zhzhen0626/FingerViP/Teleop/data/user_data/image/example_user.jpg

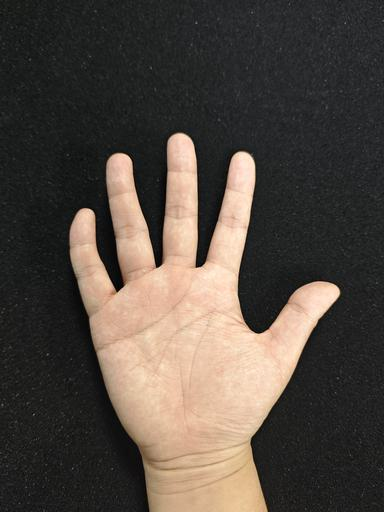
Teleop/data/user_data/image/example_user.jpg
