zhzhen0626/FingerViP/DiffusionPolicy/dexterous_hand/assets/arm/collision/upperarm.obj

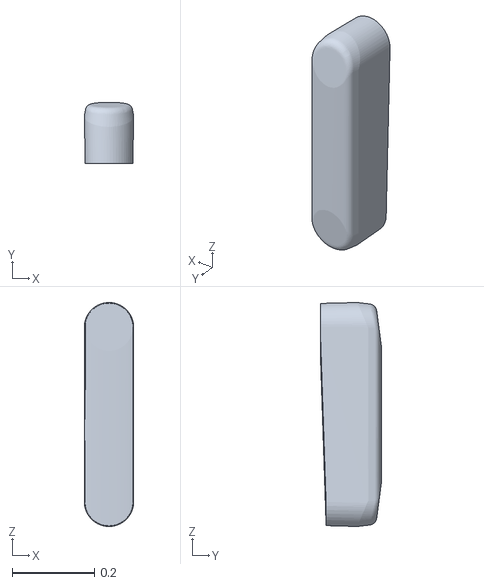
[picture p7: CAD file, 2026-09-24]
DiffusionPolicy/dexterous_hand/assets/arm/collision/upperarm.obj
0.12 x 0.15 x 0.545
