zhzhen0626/FingerViP/DiffusionPolicy/dexterous_hand/assets/arm/visual/forearm.obj

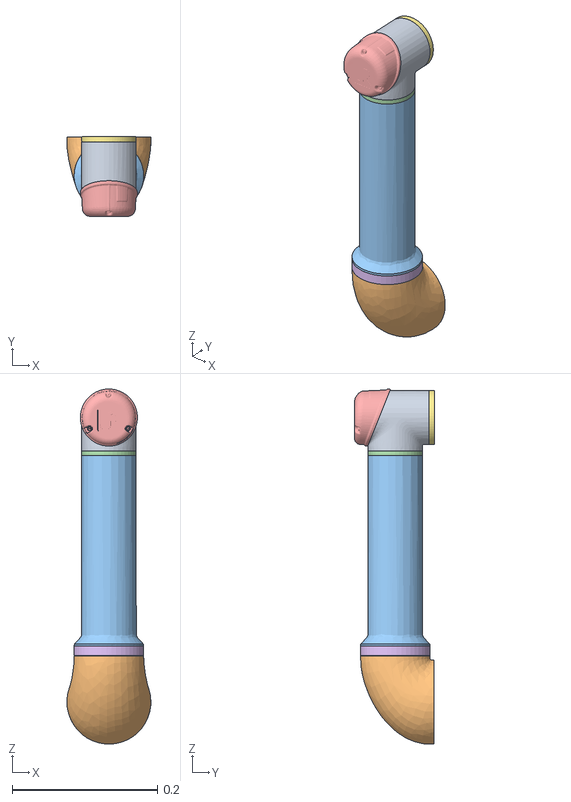
[picture p8: CAD file, 2026-09-24]
DiffusionPolicy/dexterous_hand/assets/arm/visual/forearm.obj
0.116 x 0.11 x 0.489
eSeries_UR5e_028
eSeries_UR5e_020
eSeries_UR5e_022
eSeries_UR5e_023
eSeries_UR5e_024
eSeries_UR5e_021
eSeries_UR5e_025
