zhzhen0626/FingerViP/DiffusionPolicy/dexterous_hand/assets/hand/RPIP.STL

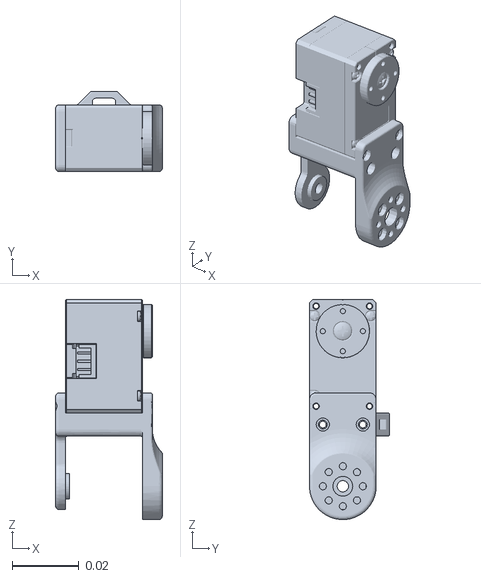
[picture p9: CAD file, 2026-09-24]
DiffusionPolicy/dexterous_hand/assets/hand/RPIP.STL
0.032 x 0.024 x 0.066
