zhzhen0626/FingerViP/Hardware/mechanical_structure/3D Printed Parts/Finger/F2.STL

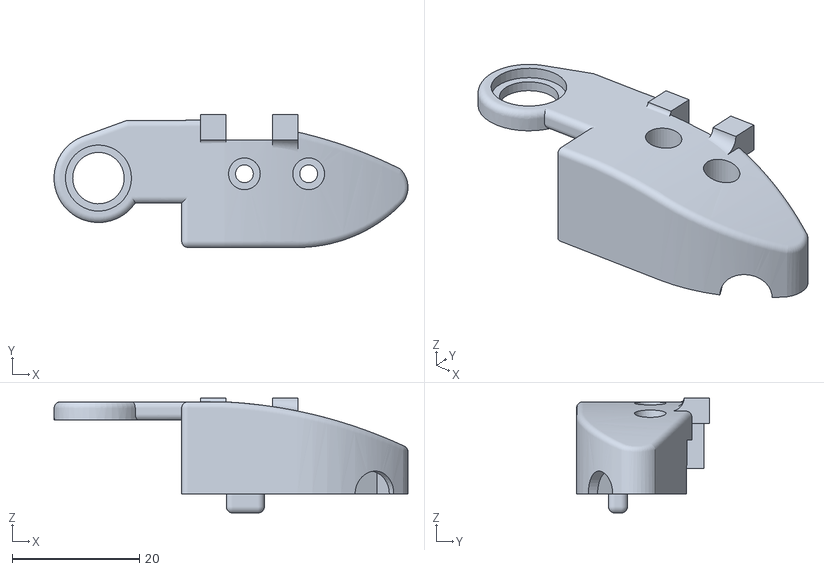
[picture p10: CAD file, 2026-09-24]
Hardware/mechanical_structure/3D Printed Parts/Finger/F2.STL
55.7 x 20.9 x 18.1
