zhzhen0626/FingerViP/Hardware/mechanical_structure/3D Printed Parts/Thumb/T2.STL

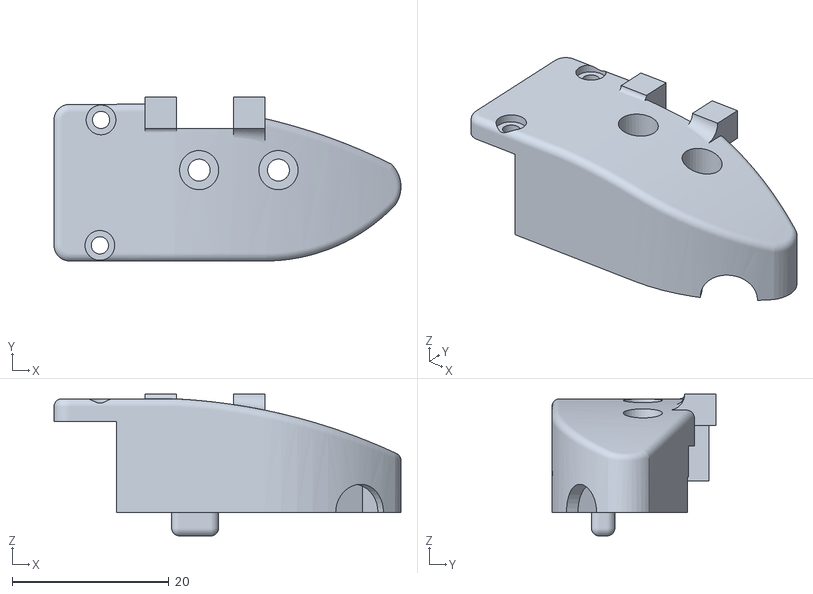
[picture p11: CAD file, 2026-09-24]
Hardware/mechanical_structure/3D Printed Parts/Thumb/T2.STL
44.3 x 20.9 x 18.1
