zhzhen0626/FingerViP/Hardware/mechanical_structure/Model/Finger/Finger.STEP

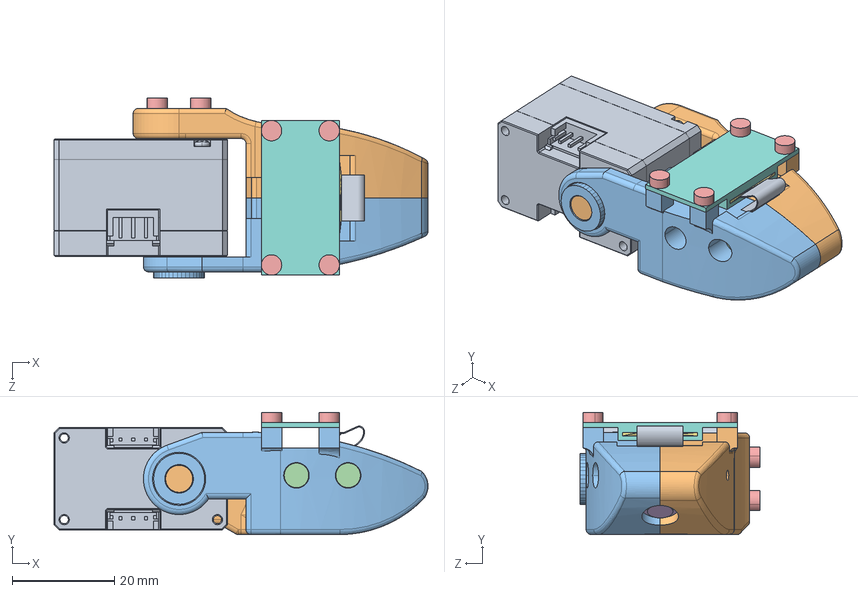
[picture p12: CAD file, 2026-09-24]
Hardware/mechanical_structure/Model/Finger/Finger.STEP
73.2 x 23.9 x 35.1 mm
f1-CamtipR
f2-CamTipL
m2.5_12 x 2
m2_4 x 8
camera.step
XL,XC-330
m3_6
p1-Idler_pin
