zhzhen0626/FingerViP/Teleop/assets/robots/arms/ur10e/meshes/collision/forearm.obj

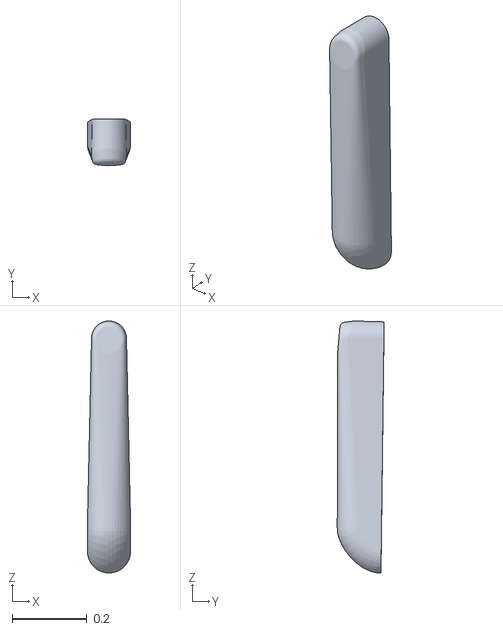
[picture p14: CAD file, 2026-09-24]
Teleop/assets/robots/arms/ur10e/meshes/collision/forearm.obj
0.116 x 0.125 x 0.676
