zhzhen0626/FingerViP/Teleop/assets/robots/arms/ur10e/meshes/visual/base.obj

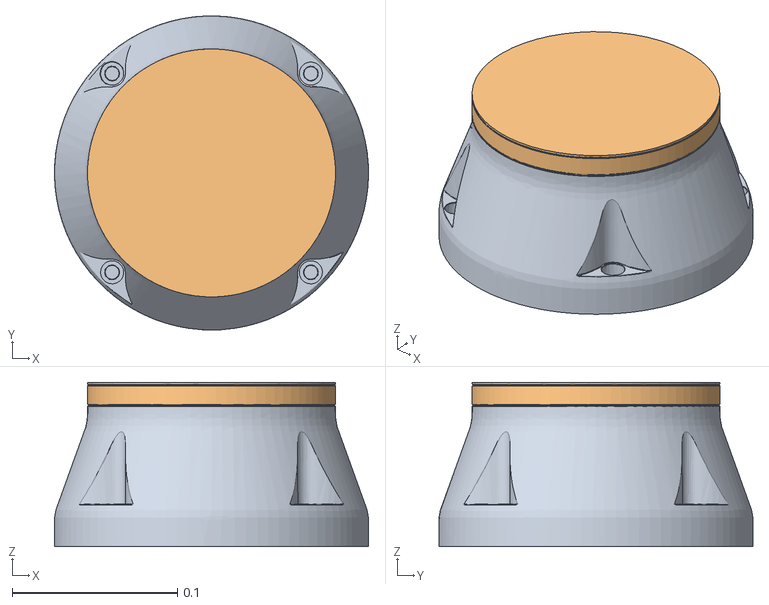
[picture p15: CAD file, 2026-09-24]
Teleop/assets/robots/arms/ur10e/meshes/visual/base.obj
0.19 x 0.19 x 0.0993
eSeries_UR10e_010
eSeries_UR10e_001
