zhzhen0626/FingerViP/Teleop/assets/robots/arms/ur5e/meshes/collision/base.obj

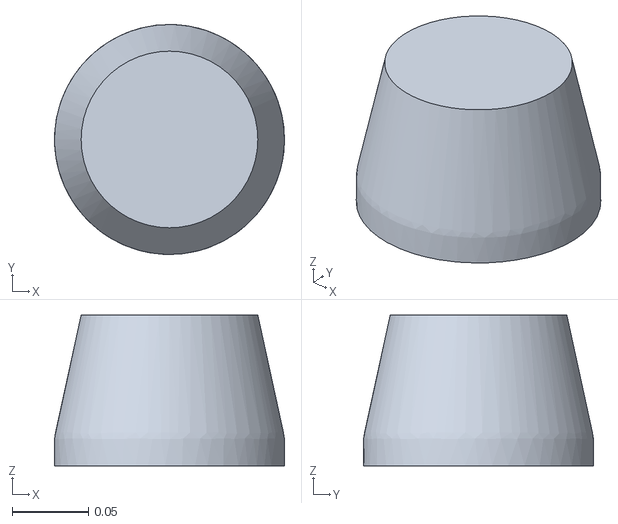
[picture p16: CAD file, 2026-09-24]
Teleop/assets/robots/arms/ur5e/meshes/collision/base.obj
0.151 x 0.151 x 0.0991
