zhzhen0626/FingerViP/Teleop/assets/robots/arms/ur5e/meshes/visual/wrist1.obj

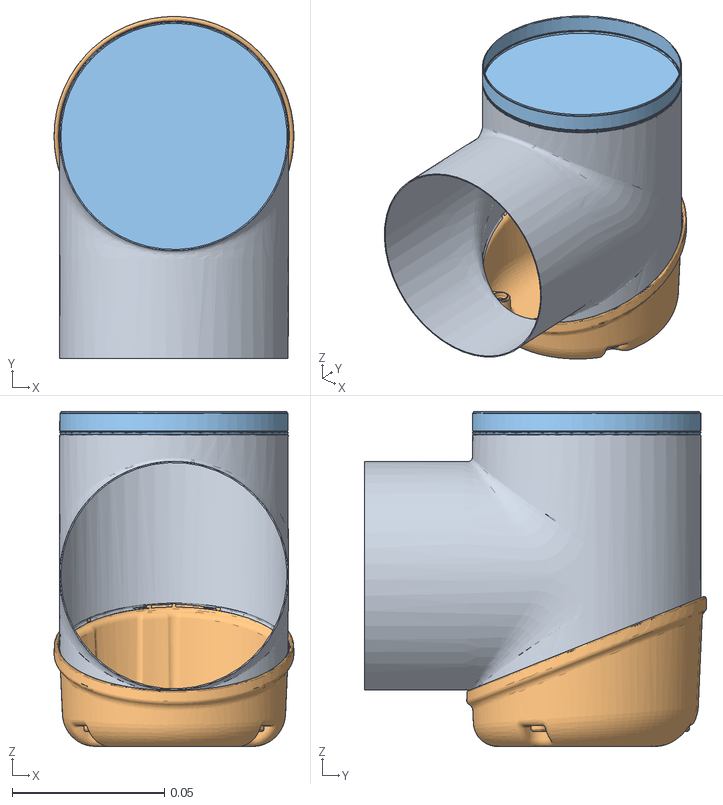
[picture p17: CAD file, 2026-09-24]
Teleop/assets/robots/arms/ur5e/meshes/visual/wrist1.obj
0.0787 x 0.112 x 0.11
eSeries_UR5e_043
eSeries_UR5e_026
eSeries_UR5e_027
