zhzhen0626/FingerViP/Teleop/assets/robots/hands/allegro_hand/meshes/collision/link_tip.obj

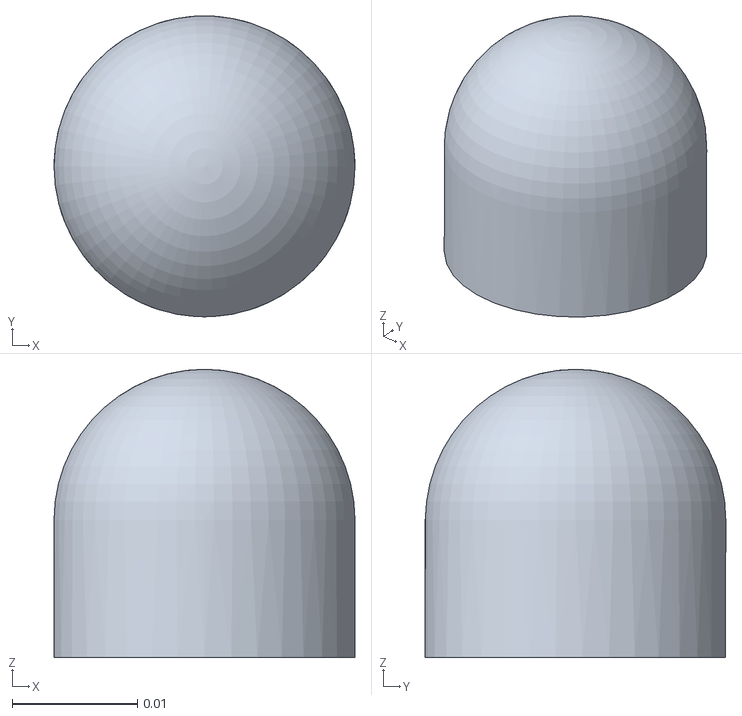
[picture p18: CAD file, 2026-09-24]
Teleop/assets/robots/hands/allegro_hand/meshes/collision/link_tip.obj
0.024 x 0.024 x 0.023
