zhzhen0626/FingerViP/Teleop/assets/robots/hands/allegro_hand/variation/meshes/collision/longer_finger_tip.obj

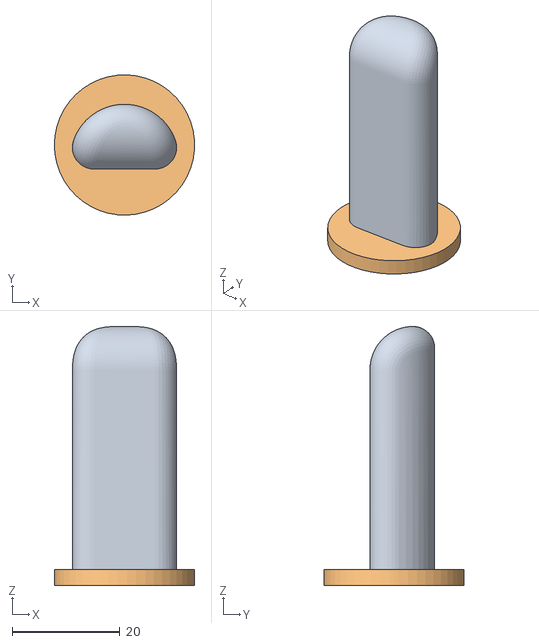
[picture p19: CAD file, 2026-09-24]
Teleop/assets/robots/hands/allegro_hand/variation/meshes/collision/longer_finger_tip.obj
26.0 x 26.0 x 48.0
geometry_0
geometry_1
