zhzhen0626/FingerViP/Teleop/assets/robots/hands/allegro_hand/variation/meshes/visual/tactile.obj

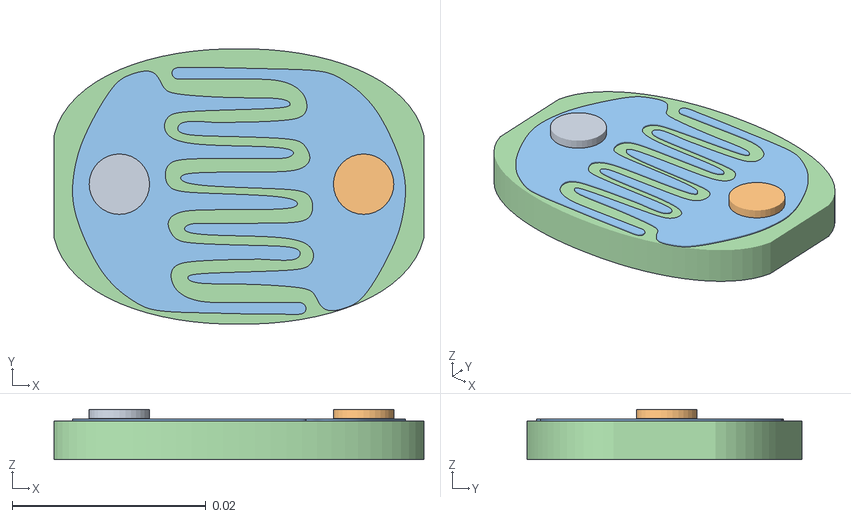
[picture p20: CAD file, 2026-09-24]
Teleop/assets/robots/hands/allegro_hand/variation/meshes/visual/tactile.obj
0.0382 x 0.0284 x 0.00519
LIGHT_CATCHER_2
photocell
