zhzhen0626/FingerViP/Teleop/assets/robots/hands/leap_hand/meshes/collision/white_tip_thumb.obj

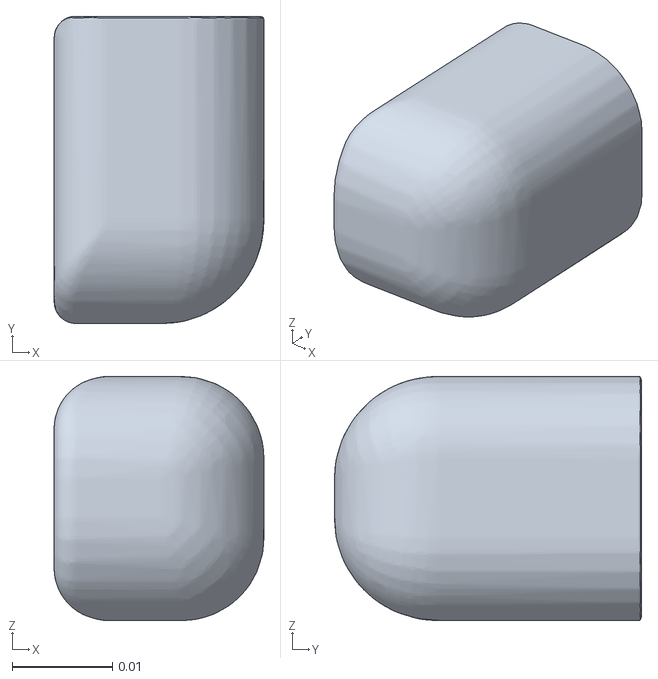
[picture p21: CAD file, 2026-09-24]
Teleop/assets/robots/hands/leap_hand/meshes/collision/white_tip_thumb.obj
0.0209 x 0.0306 x 0.0243
