zhzhen0626/FingerViP/Teleop/assets/robots/hands/leap_hand/meshes/visual/dip.obj

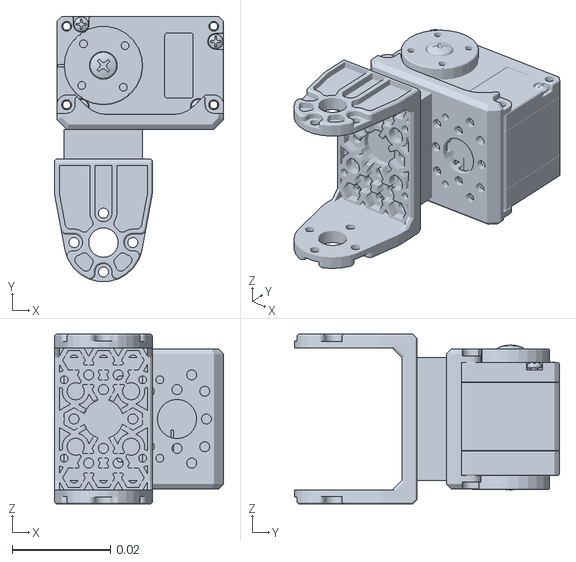
[picture p22: CAD file, 2026-09-24]
Teleop/assets/robots/hands/leap_hand/meshes/visual/dip.obj
0.0345 x 0.054 x 0.0346
