zhzhen0626/FingerViP/Teleop/assets/robots/hands/rapid_hand/meshes/TDIP.STL

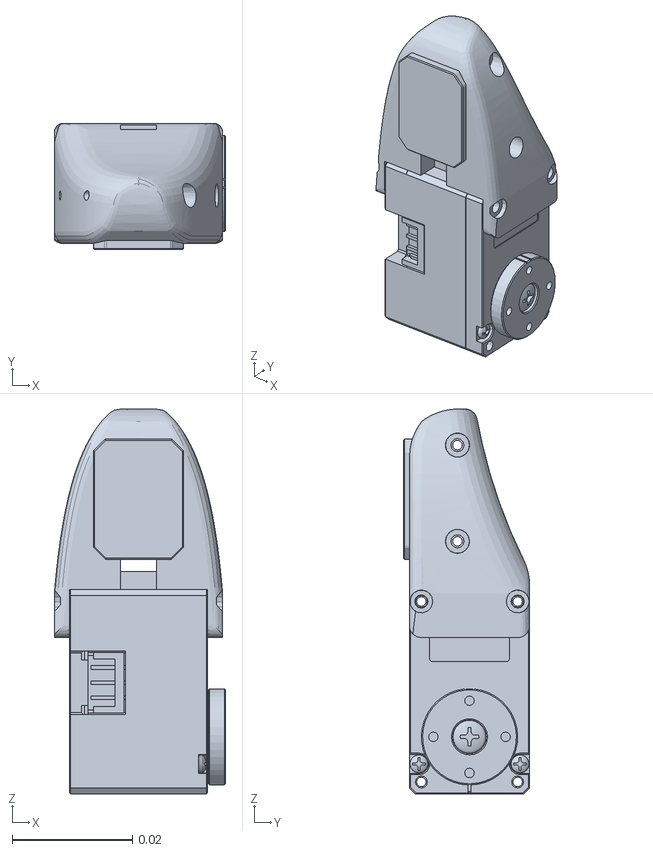
[picture p23: CAD file, 2026-09-24]
Teleop/assets/robots/hands/rapid_hand/meshes/TDIP.STL
0.0285 x 0.021 x 0.064
