zhzhen0626/FingerViP/DiffusionPolicy/dexterous_hand/assets/arm/collision/wrist3.obj

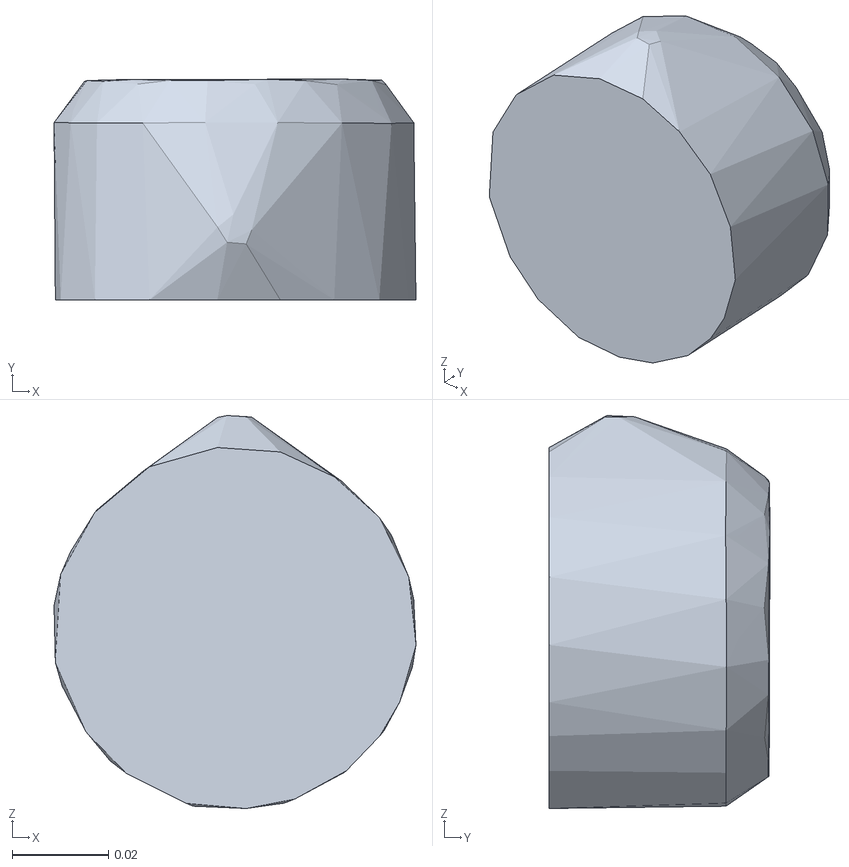
[picture p24: CAD file, 2026-09-24]
DiffusionPolicy/dexterous_hand/assets/arm/collision/wrist3.obj
0.0751 x 0.0458 x 0.0816
