zhzhen0626/FingerViP/DiffusionPolicy/dexterous_hand/assets/arm/visual/upperarm.obj

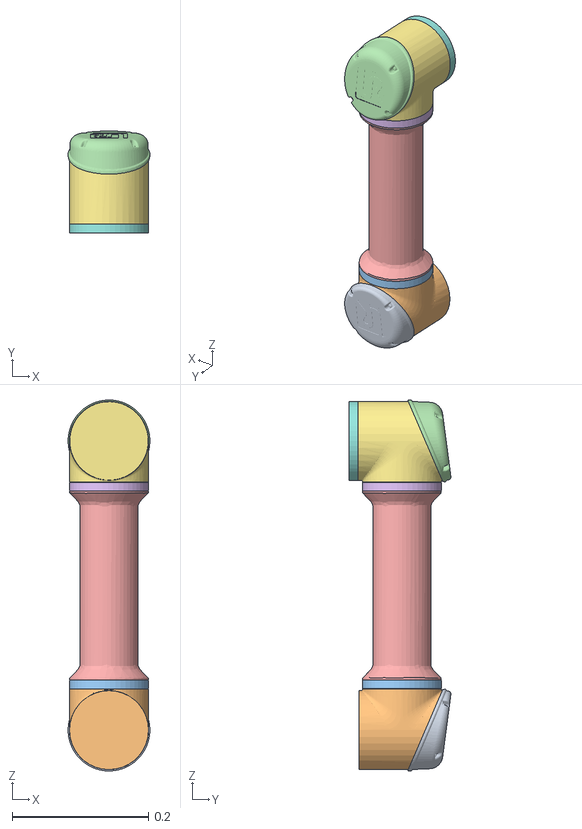
[picture p25: CAD file, 2026-09-24]
DiffusionPolicy/dexterous_hand/assets/arm/visual/upperarm.obj
0.12 x 0.15 x 0.545
eSeries_UR5e_009
eSeries_UR5e_010
eSeries_UR5e_011
eSeries_UR5e_012
eSeries_UR5e_014
eSeries_UR5e_017
eSeries_UR5e_018
eSeries_UR5e_019
