zhzhen0626/FingerViP/DiffusionPolicy/dexterous_hand/assets/hand/IDIP_CT.STL

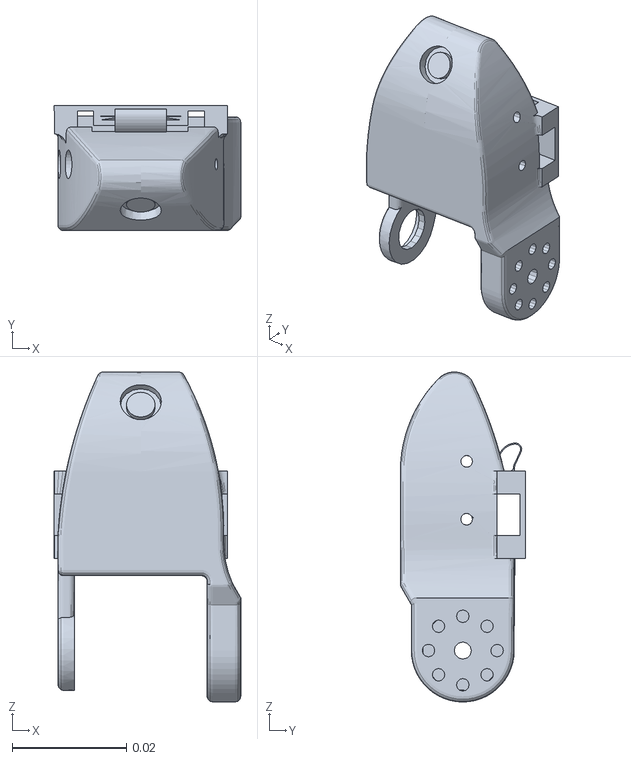
[picture p26: CAD file, 2026-09-24]
DiffusionPolicy/dexterous_hand/assets/hand/IDIP_CT.STL
0.0326 x 0.0219 x 0.0577
