zhzhen0626/FingerViP/Hardware/mechanical_structure/3D Printed Parts/Finger/F1.STL

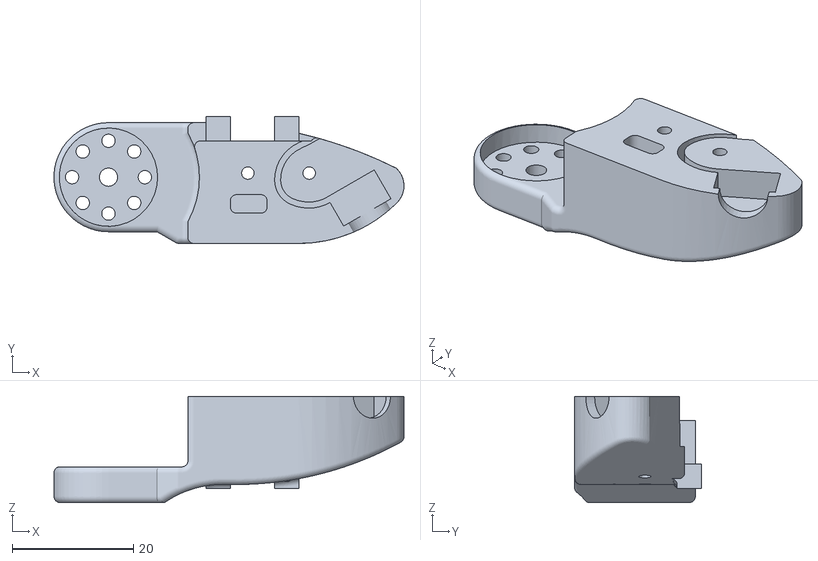
[picture p27: CAD file, 2026-09-24]
Hardware/mechanical_structure/3D Printed Parts/Finger/F1.STL
57.7 x 20.9 x 17.5
