zhzhen0626/FingerViP/Hardware/mechanical_structure/3D Printed Parts/Thumb/T1.STL

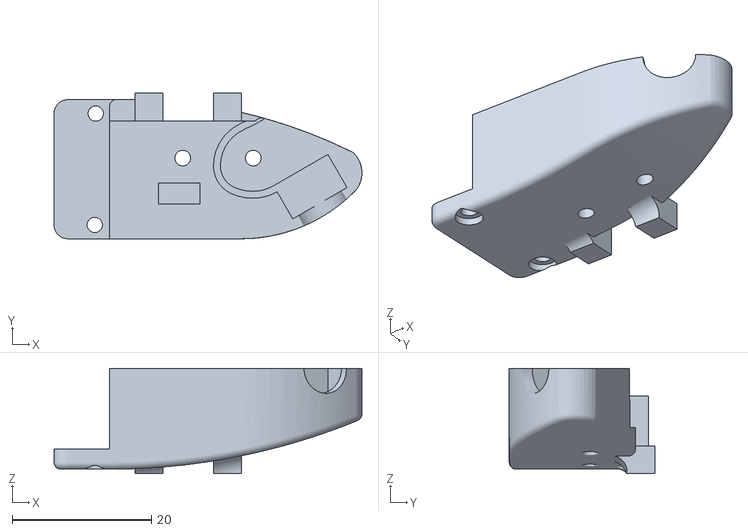
[picture p28: CAD file, 2026-09-24]
Hardware/mechanical_structure/3D Printed Parts/Thumb/T1.STL
44.3 x 20.9 x 15.2
