zhzhen0626/FingerViP/Teleop/assets/robots/arms/ur10e/meshes/collision/shoulder.obj

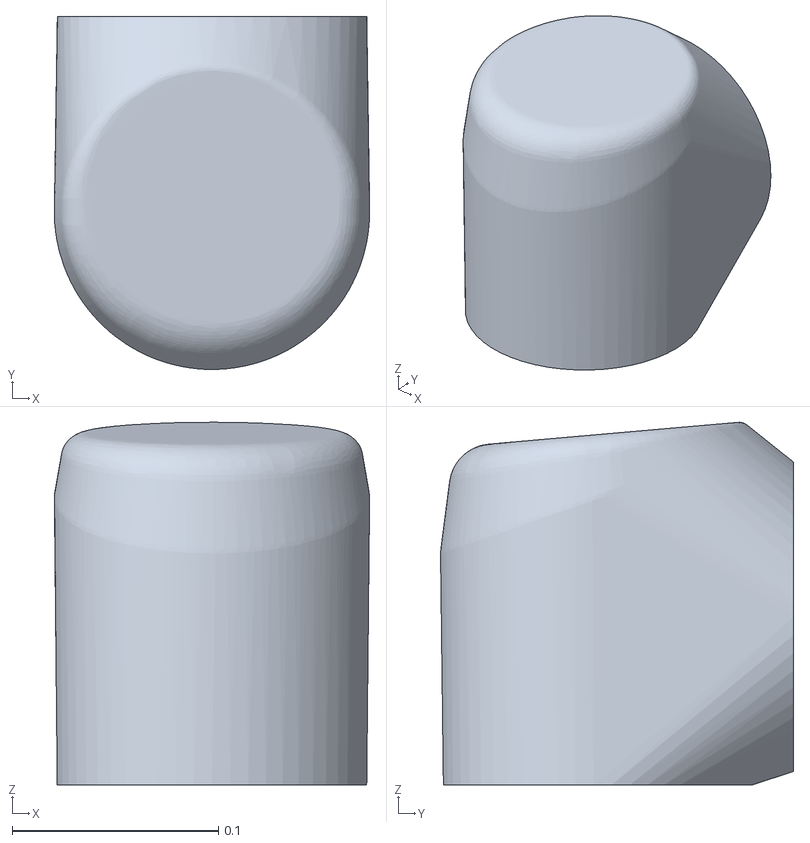
[picture p29: CAD file, 2026-09-24]
Teleop/assets/robots/arms/ur10e/meshes/collision/shoulder.obj
0.153 x 0.171 x 0.176
