zhzhen0626/FingerViP/Teleop/assets/robots/arms/ur10e/meshes/visual/shoulder.obj

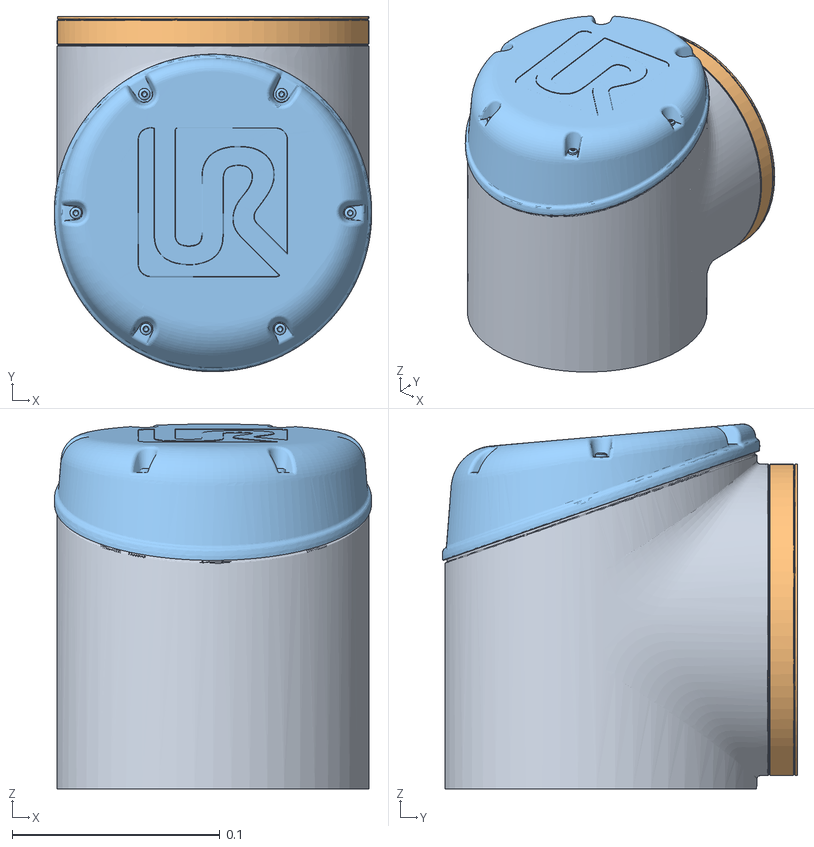
[picture p30: CAD file, 2026-09-24]
Teleop/assets/robots/arms/ur10e/meshes/visual/shoulder.obj
0.153 x 0.171 x 0.176
eSeries_UR10e_023
eSeries_UR10e_002
eSeries_UR10e_003
