zhzhen0626/FingerViP/Teleop/assets/robots/arms/ur5e/meshes/collision/forearm.obj

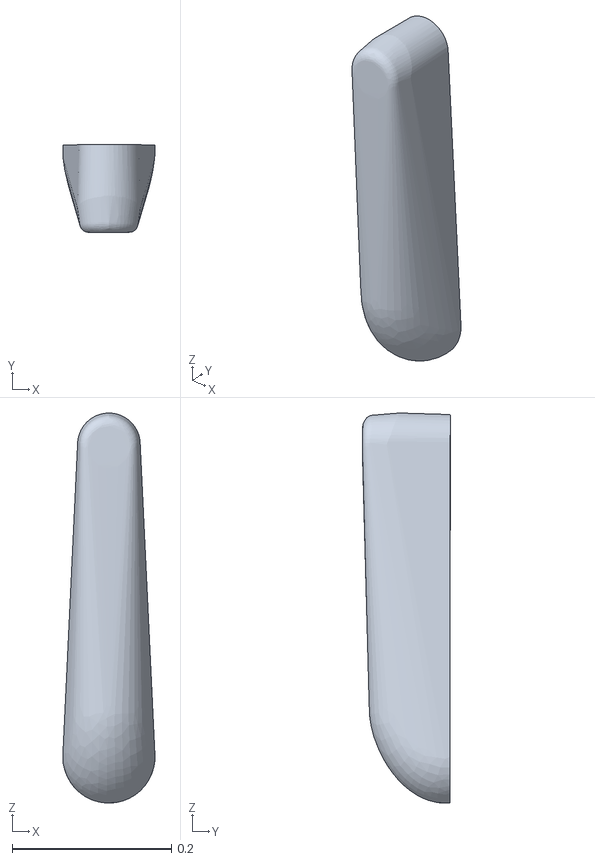
[picture p31: CAD file, 2026-09-24]
Teleop/assets/robots/arms/ur5e/meshes/collision/forearm.obj
0.116 x 0.11 x 0.489
