zhzhen0626/FingerViP/Teleop/assets/robots/arms/ur5e/meshes/visual/shoulder.obj

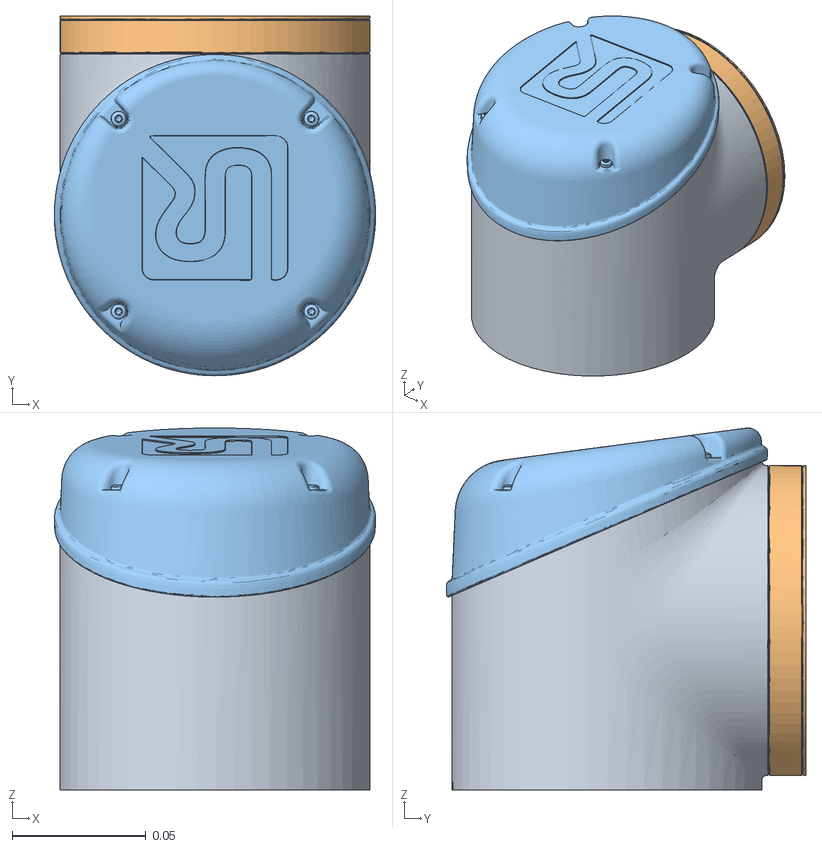
[picture p32: CAD file, 2026-09-24]
Teleop/assets/robots/arms/ur5e/meshes/visual/shoulder.obj
0.12 x 0.135 x 0.135
eSeries_UR5e_001
eSeries_UR5e_007
eSeries_UR5e_008
