zhzhen0626/FingerViP/Teleop/assets/robots/hands/allegro_hand/meshes/visual/base_link.obj

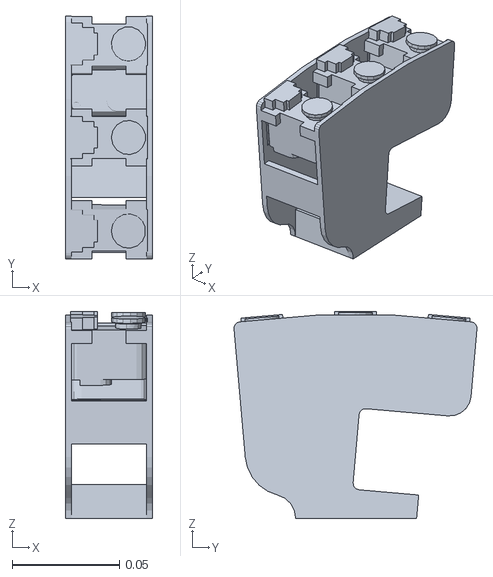
[picture p33: CAD file, 2026-09-24]
Teleop/assets/robots/hands/allegro_hand/meshes/visual/base_link.obj
0.0408 x 0.113 x 0.0967
