zhzhen0626/FingerViP/Teleop/assets/robots/hands/allegro_hand/variation/meshes/visual/longer_finger_tip.obj

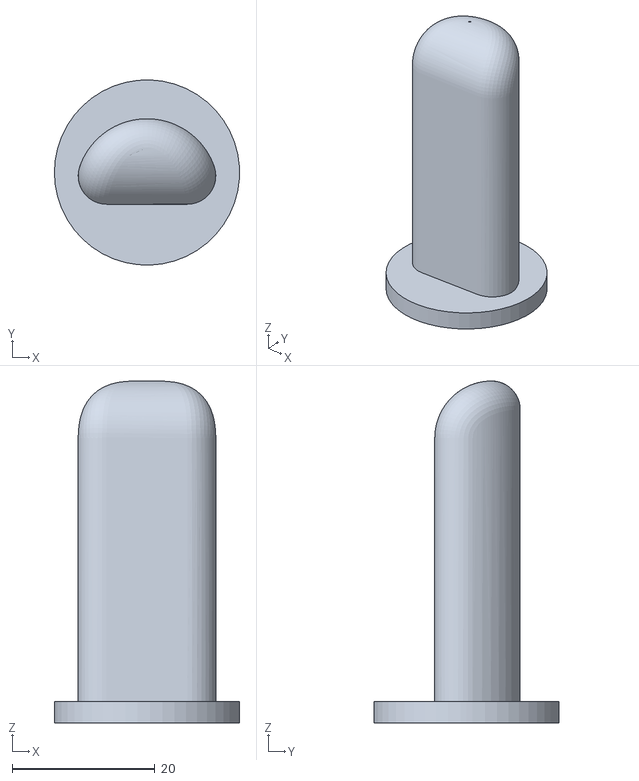
[picture p34: CAD file, 2026-09-24]
Teleop/assets/robots/hands/allegro_hand/variation/meshes/visual/longer_finger_tip.obj
26.0 x 26.0 x 48.0
