zhzhen0626/FingerViP/Teleop/assets/robots/hands/leap_hand/meshes/visual/pip_left.obj

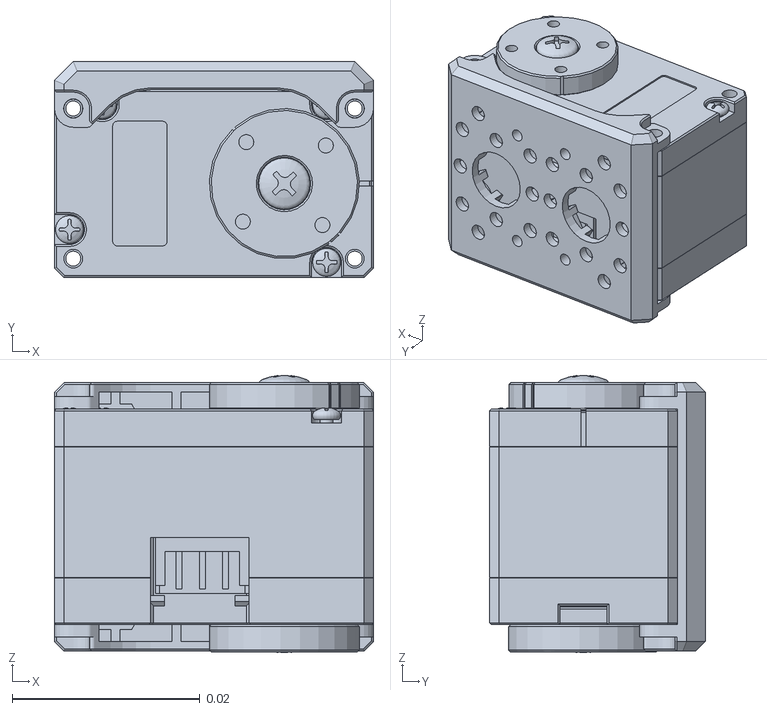
[picture p35: CAD file, 2026-09-24]
Teleop/assets/robots/hands/leap_hand/meshes/visual/pip_left.obj
0.034 x 0.023 x 0.0295
