zhzhen0626/FingerViP/Teleop/assets/robots/hands/rapid_hand/meshes/IDIP.STL

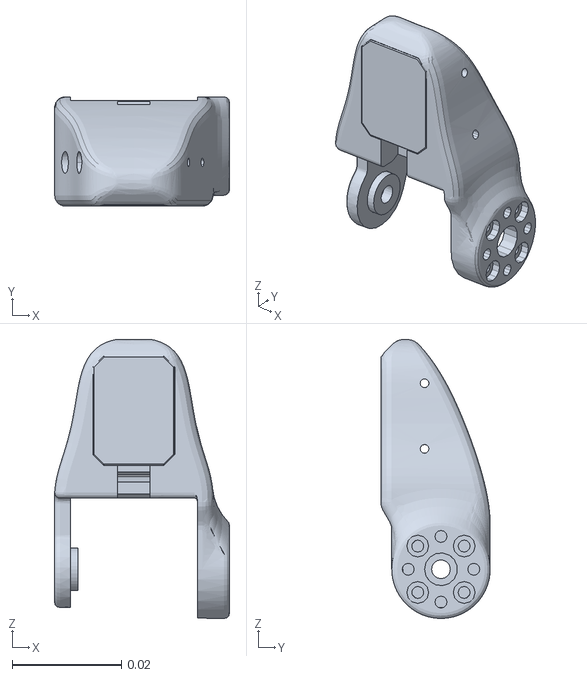
[picture p36: CAD file, 2026-09-24]
Teleop/assets/robots/hands/rapid_hand/meshes/IDIP.STL
0.032 x 0.02 x 0.051
