zhzhen0626/FingerViP/DiffusionPolicy/dexterous_hand/assets/arm/collision/wrist2.obj

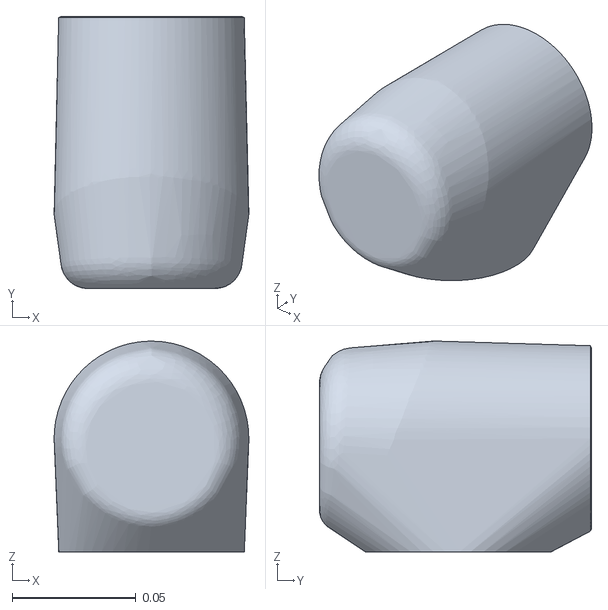
[picture p37: CAD file, 2026-09-24]
DiffusionPolicy/dexterous_hand/assets/arm/collision/wrist2.obj
0.0787 x 0.11 x 0.0852
