zhzhen0626/FingerViP/DiffusionPolicy/dexterous_hand/assets/arm/visual/wrist2.obj

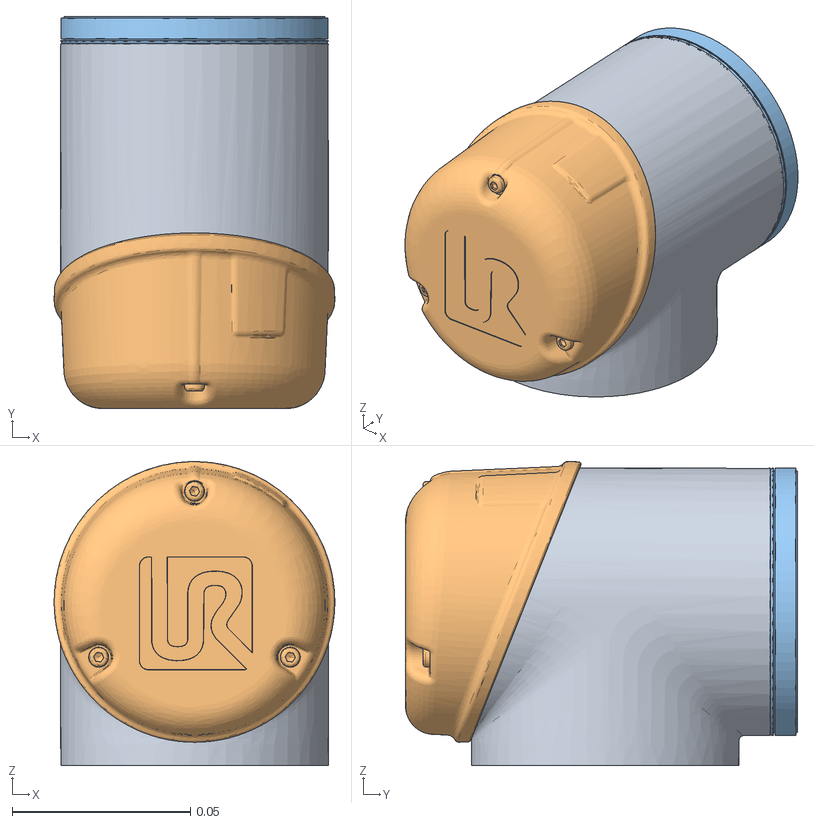
[picture p38: CAD file, 2026-09-24]
DiffusionPolicy/dexterous_hand/assets/arm/visual/wrist2.obj
0.0787 x 0.11 x 0.0852
eSeries_UR5e_049
eSeries_UR5e_029
eSeries_UR5e_002
