zhzhen0626/FingerViP/DiffusionPolicy/dexterous_hand/assets/hand/TMCPF.STL

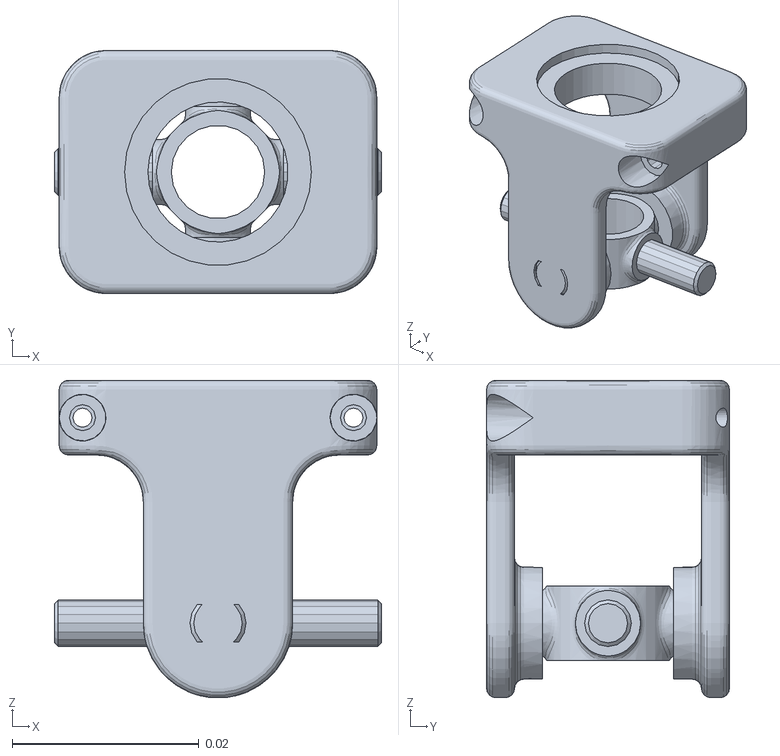
[picture p39: CAD file, 2026-09-24]
DiffusionPolicy/dexterous_hand/assets/hand/TMCPF.STL
0.035 x 0.026 x 0.034
