zhzhen0626/FingerViP/Teleop/assets/robots/arms/ur10e/meshes/collision/wrist3.obj

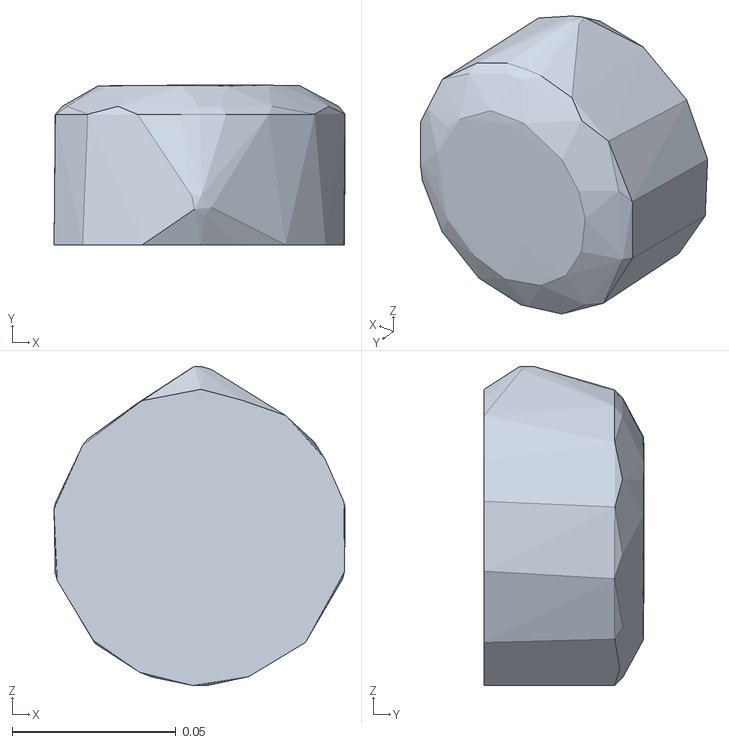
[picture p40: CAD file, 2026-09-24]
Teleop/assets/robots/arms/ur10e/meshes/collision/wrist3.obj
0.0888 x 0.0488 x 0.0974
