zhzhen0626/FingerViP/Teleop/assets/robots/arms/ur10e/meshes/visual/wrist1.obj

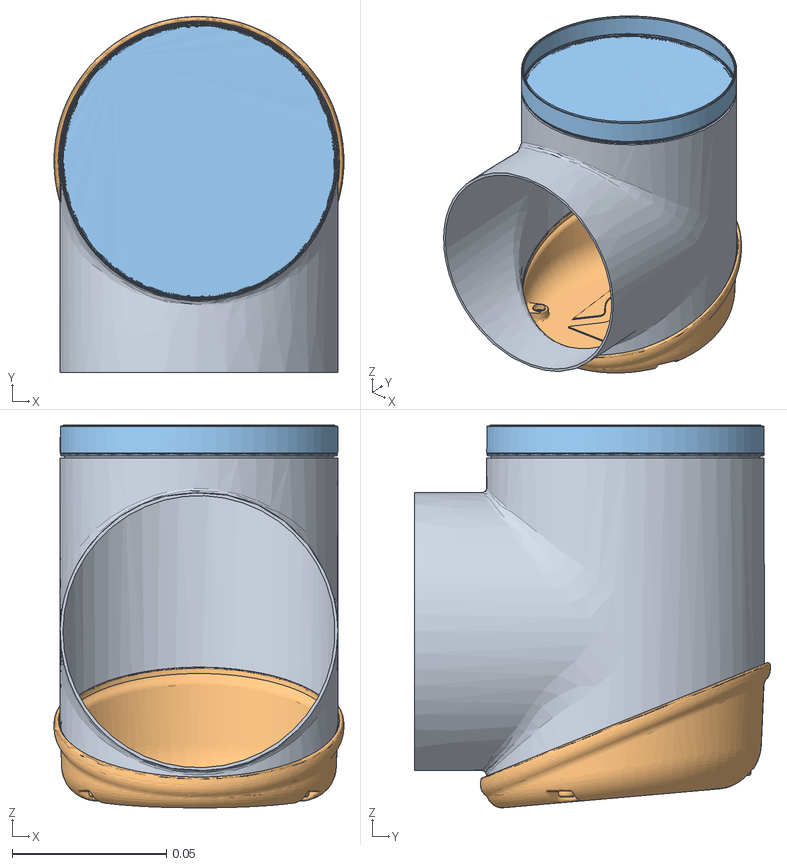
[picture p41: CAD file, 2026-09-24]
Teleop/assets/robots/arms/ur10e/meshes/visual/wrist1.obj
0.094 x 0.115 x 0.124
eSeries_UR10e_037
eSeries_UR10e_021
eSeries_UR10e_022
