zhzhen0626/FingerViP/Teleop/assets/robots/arms/ur5e/meshes/visual/wrist3.obj

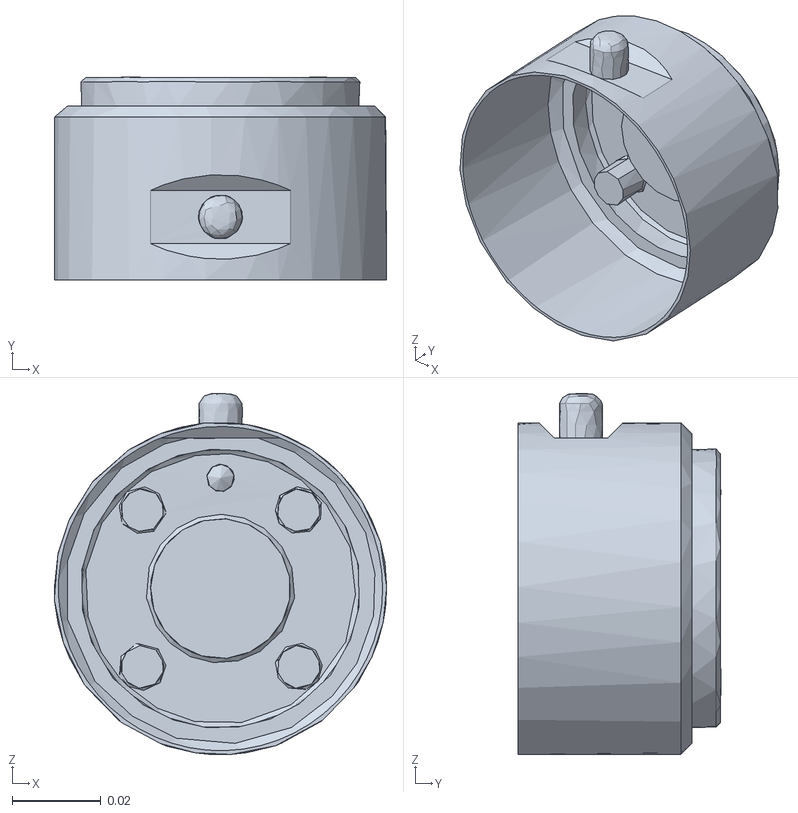
[picture p42: CAD file, 2026-09-24]
Teleop/assets/robots/arms/ur5e/meshes/visual/wrist3.obj
0.0751 x 0.0458 x 0.0816
