zhzhen0626/FingerViP/Teleop/assets/robots/hands/leap_hand/meshes/visual/thumb_pip.obj

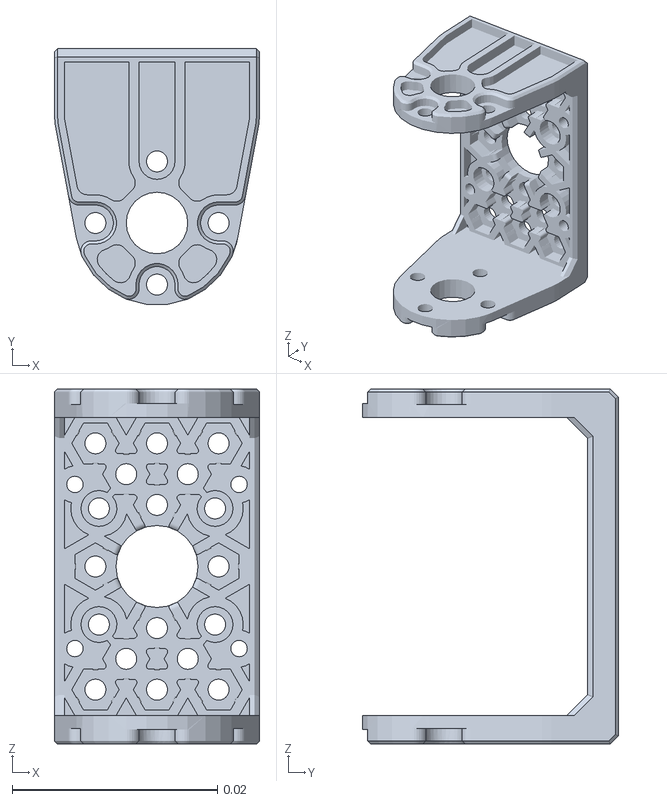
[picture p44: CAD file, 2026-09-24]
Teleop/assets/robots/hands/leap_hand/meshes/visual/thumb_pip.obj
0.02 x 0.0249 x 0.0346
