zhzhen0626/FingerViP/Teleop/assets/robots/hands/rapid_hand/meshes/BASE.STL

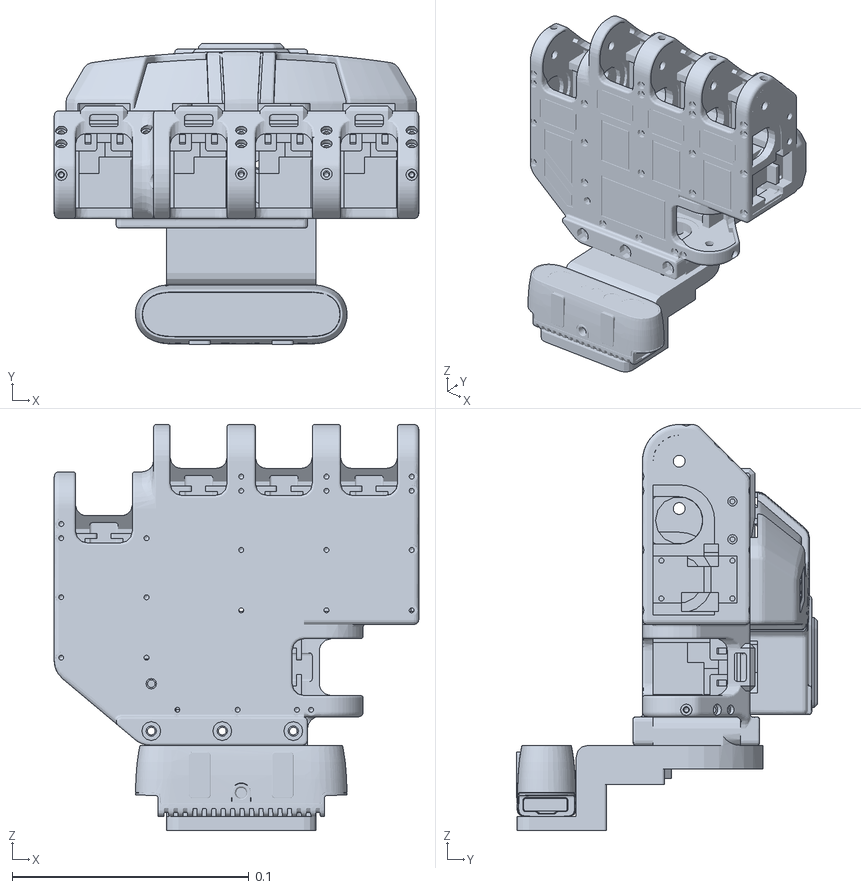
[picture p45: CAD file, 2026-09-24]
Teleop/assets/robots/hands/rapid_hand/meshes/BASE.STL
0.154 x 0.127 x 0.172
