zhzhen0626/FingerViP/DiffusionPolicy/dexterous_hand/assets/arm/collision/shoulder.obj

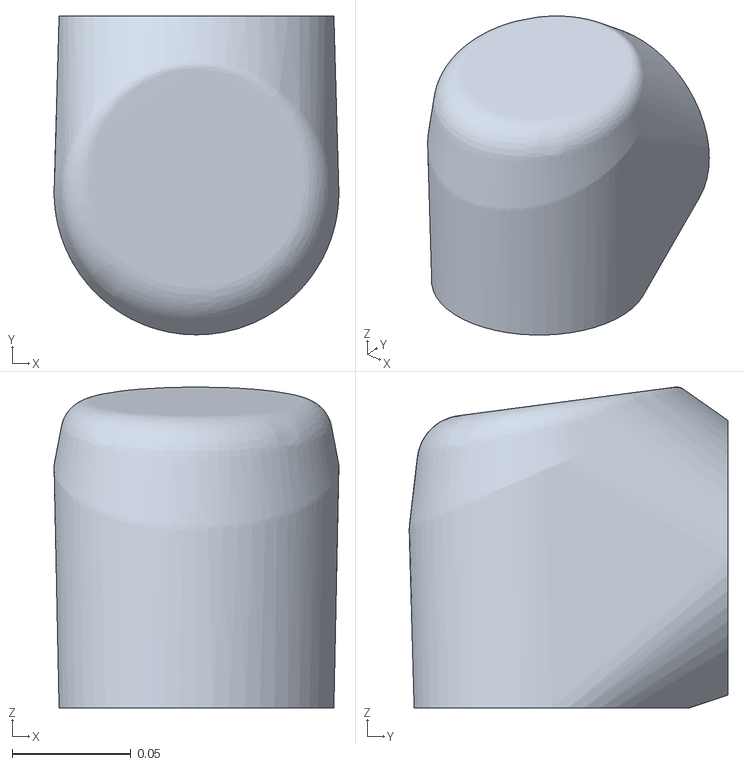
[picture p46: CAD file, 2026-09-24]
DiffusionPolicy/dexterous_hand/assets/arm/collision/shoulder.obj
0.12 x 0.134 x 0.135
