zhzhen0626/FingerViP/Teleop/assets/robots/arms/ur10e/meshes/collision/wrist2.obj

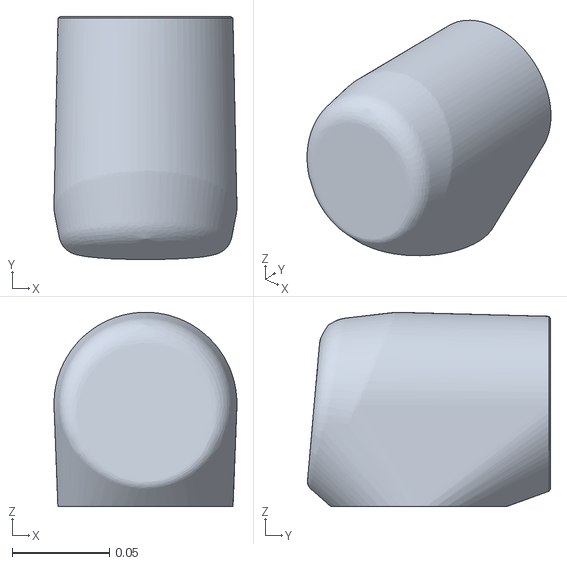
[picture p47: CAD file, 2026-09-24]
Teleop/assets/robots/arms/ur10e/meshes/collision/wrist2.obj
0.094 x 0.125 x 0.0999
