zhzhen0626/FingerViP/Teleop/assets/robots/arms/ur10e/meshes/visual/upperarm.obj

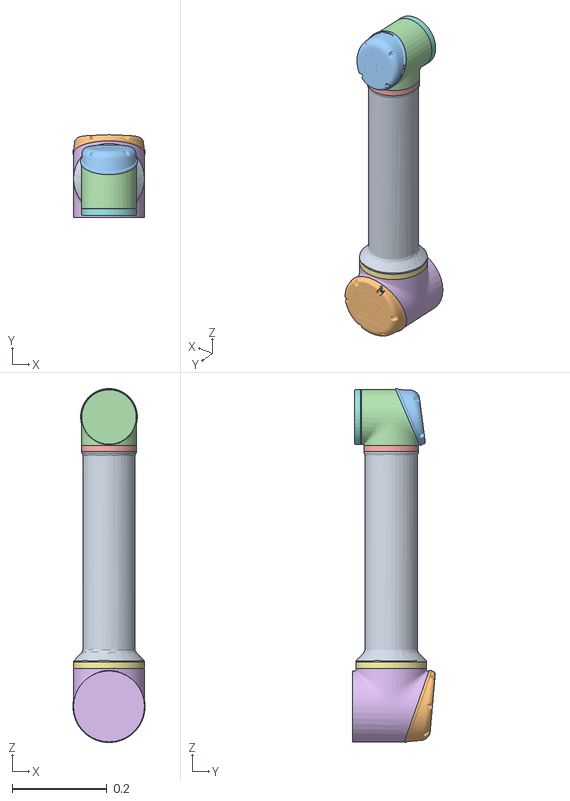
[picture p48: CAD file, 2026-09-24]
Teleop/assets/robots/arms/ur10e/meshes/visual/upperarm.obj
0.153 x 0.175 x 0.749
eSeries_UR10e_028
eSeries_UR10e_004
eSeries_UR10e_005
eSeries_UR10e_007
eSeries_UR10e_008
eSeries_UR10e_009
eSeries_UR10e_011
eSeries_UR10e_014
