zhzhen0626/FingerViP/Teleop/assets/robots/hands/leap_hand/meshes/visual/palm_lower_left.obj

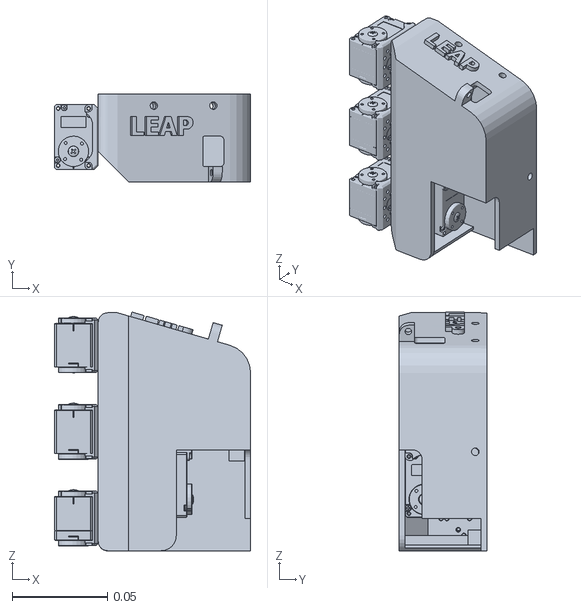
[picture p50: CAD file, 2026-09-24]
Teleop/assets/robots/hands/leap_hand/meshes/visual/palm_lower_left.obj
0.103 x 0.046 x 0.125
