zhzhen0626/FingerViP/Teleop/assets/robots/hands/rapid_hand/meshes/LMCPS.STL

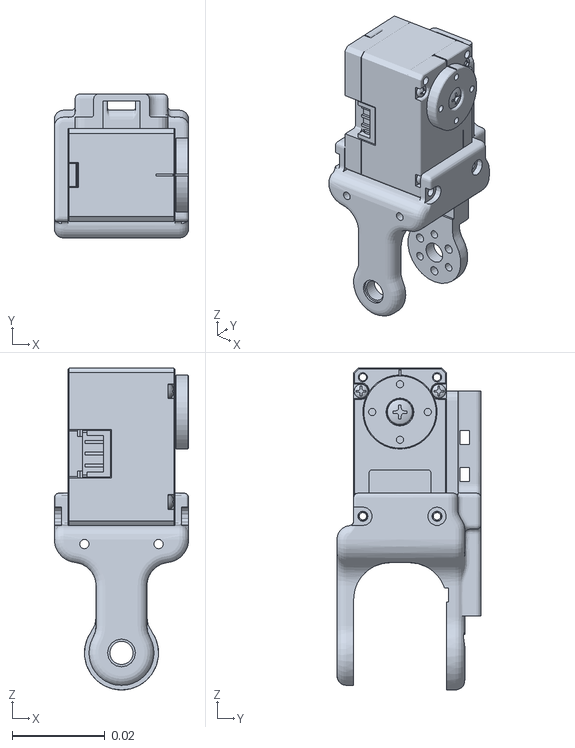
[picture p51: CAD file, 2026-09-24]
Teleop/assets/robots/hands/rapid_hand/meshes/LMCPS.STL
0.029 x 0.0311 x 0.0695
