zhzhen0626/FingerViP/DiffusionPolicy/dexterous_hand/assets/hand/IMCPF.STL

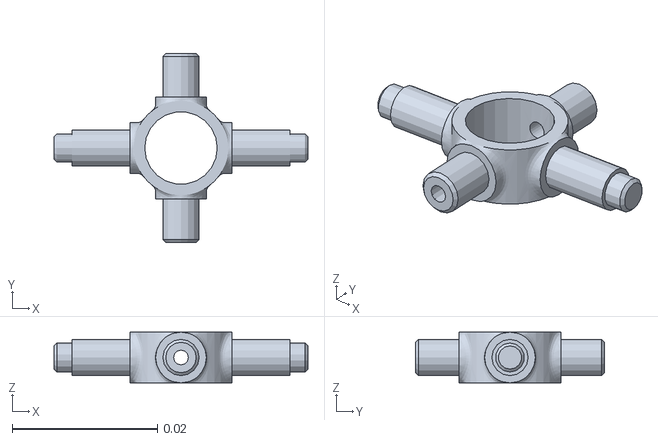
[picture p52: CAD file, 2026-09-24]
DiffusionPolicy/dexterous_hand/assets/hand/IMCPF.STL
0.035 x 0.026 x 0.007
