zhzhen0626/FingerViP/Teleop/assets/robots/arms/ur10e/meshes/visual/wrist3.obj

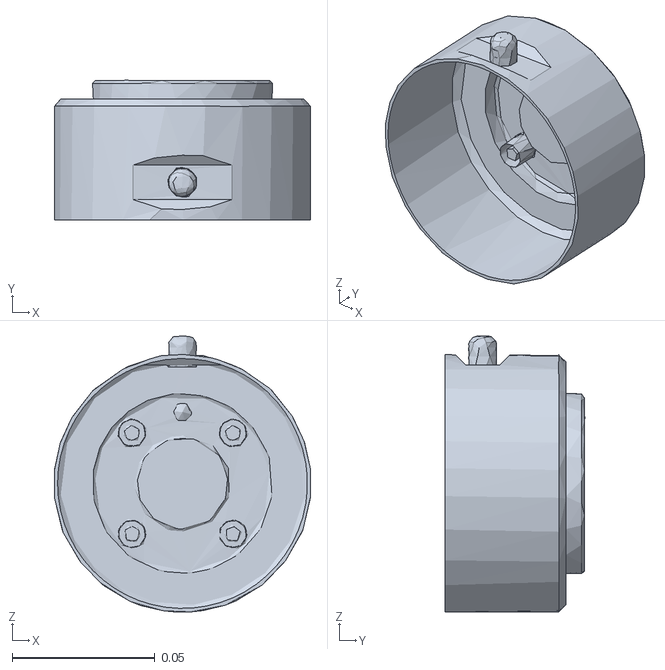
[picture p53: CAD file, 2026-09-24]
Teleop/assets/robots/arms/ur10e/meshes/visual/wrist3.obj
0.0897 x 0.0488 x 0.0966
