zhzhen0626/FingerViP/Teleop/assets/robots/arms/ur5e/meshes/collision/wrist1.obj

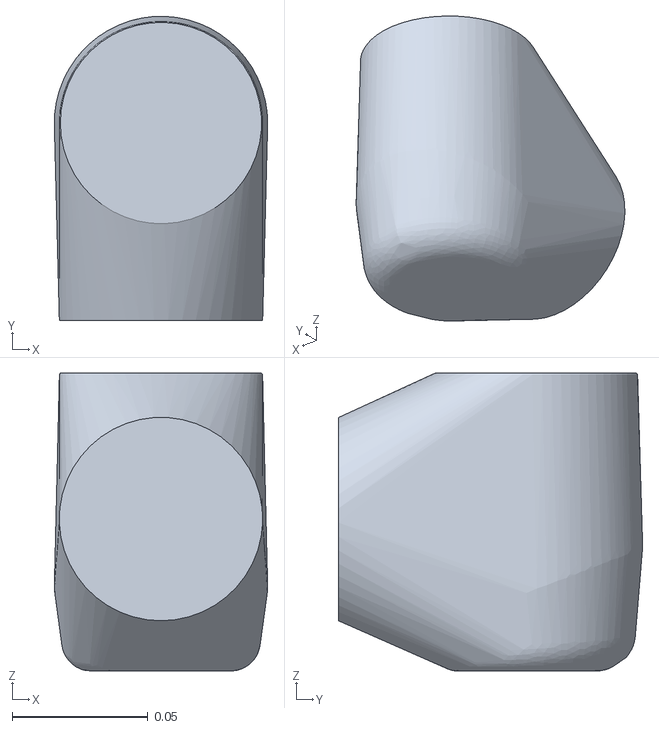
[picture p54: CAD file, 2026-09-24]
Teleop/assets/robots/arms/ur5e/meshes/collision/wrist1.obj
0.0787 x 0.112 x 0.11
