zhzhen0626/FingerViP/Teleop/assets/robots/hands/allegro_hand/meshes/visual/link_2.0.obj

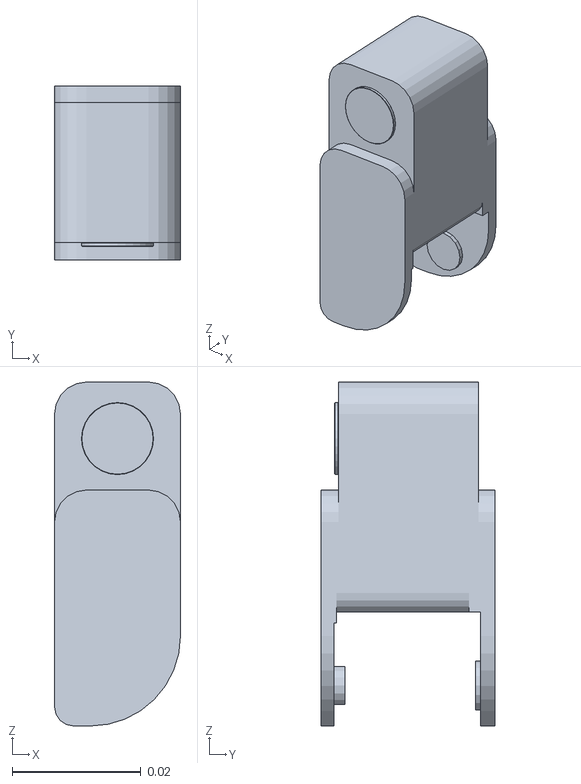
[picture p55: CAD file, 2026-09-24]
Teleop/assets/robots/hands/allegro_hand/meshes/visual/link_2.0.obj
0.0196 x 0.027 x 0.0535
