zhzhen0626/FingerViP/Teleop/assets/robots/hands/leap_hand/meshes/visual/fingertip.obj

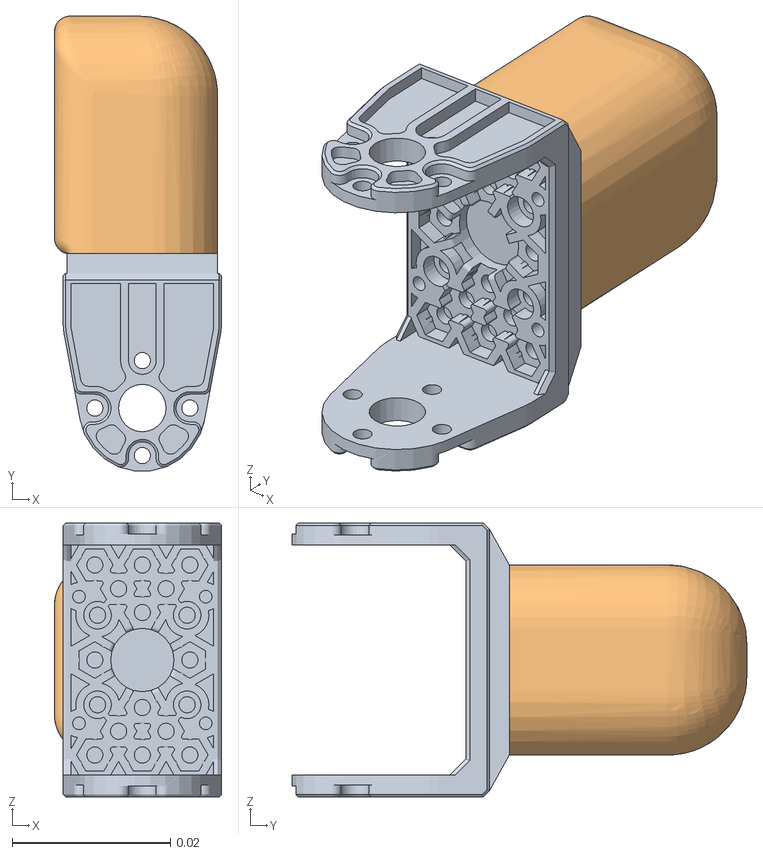
[picture p56: CAD file, 2026-09-24]
Teleop/assets/robots/hands/leap_hand/meshes/visual/fingertip.obj
0.0211 x 0.0574 x 0.0346
fingertip
fingertip_W
