zhzhen0626/FingerViP/Teleop/assets/robots/arms/ur10e/meshes/collision/wrist1.obj

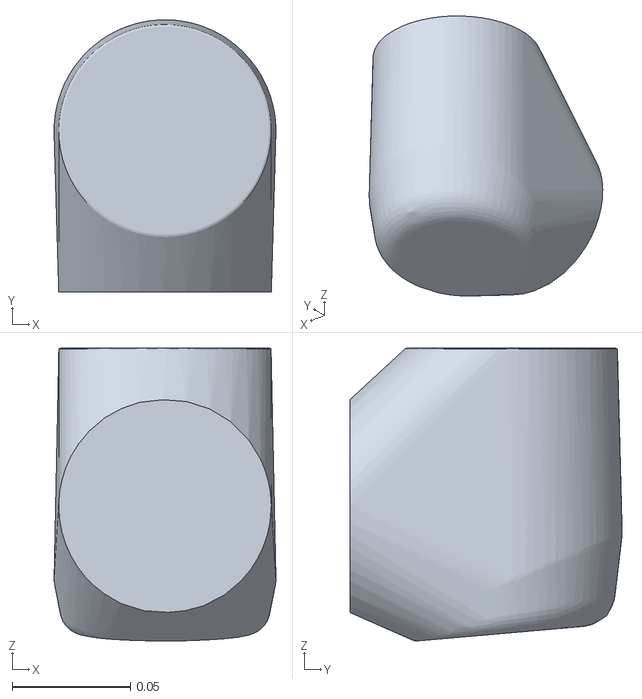
[picture p57: CAD file, 2026-09-24]
Teleop/assets/robots/arms/ur10e/meshes/collision/wrist1.obj
0.094 x 0.115 x 0.124
