zhzhen0626/FingerViP/Teleop/assets/robots/arms/ur10e/meshes/visual/forearm.obj

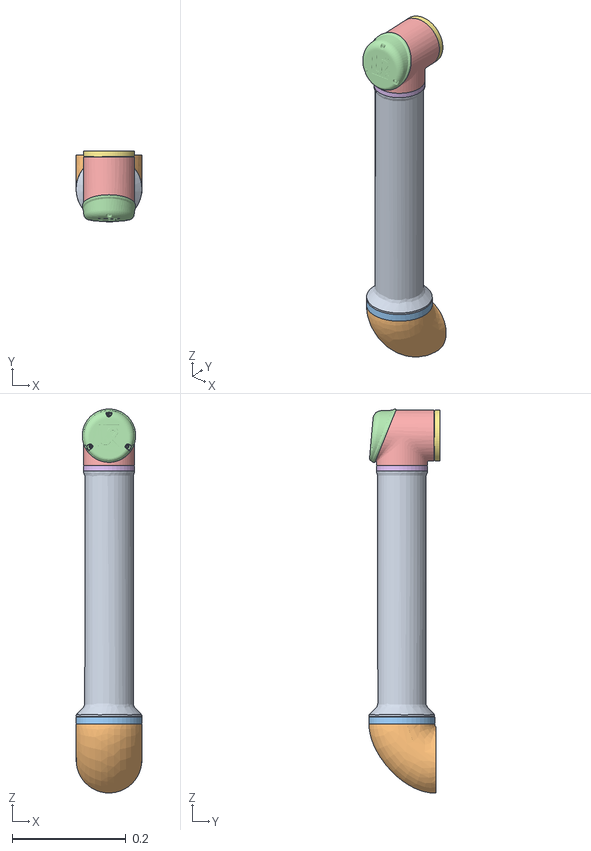
[picture p58: CAD file, 2026-09-24]
Teleop/assets/robots/arms/ur10e/meshes/visual/forearm.obj
0.116 x 0.125 x 0.676
eSeries_UR10e_031
eSeries_UR10e_015
eSeries_UR10e_016
eSeries_UR10e_017
eSeries_UR10e_018
eSeries_UR10e_019
eSeries_UR10e_020
