zhzhen0626/FingerViP/Teleop/assets/robots/arms/ur5e/meshes/visual/base.obj

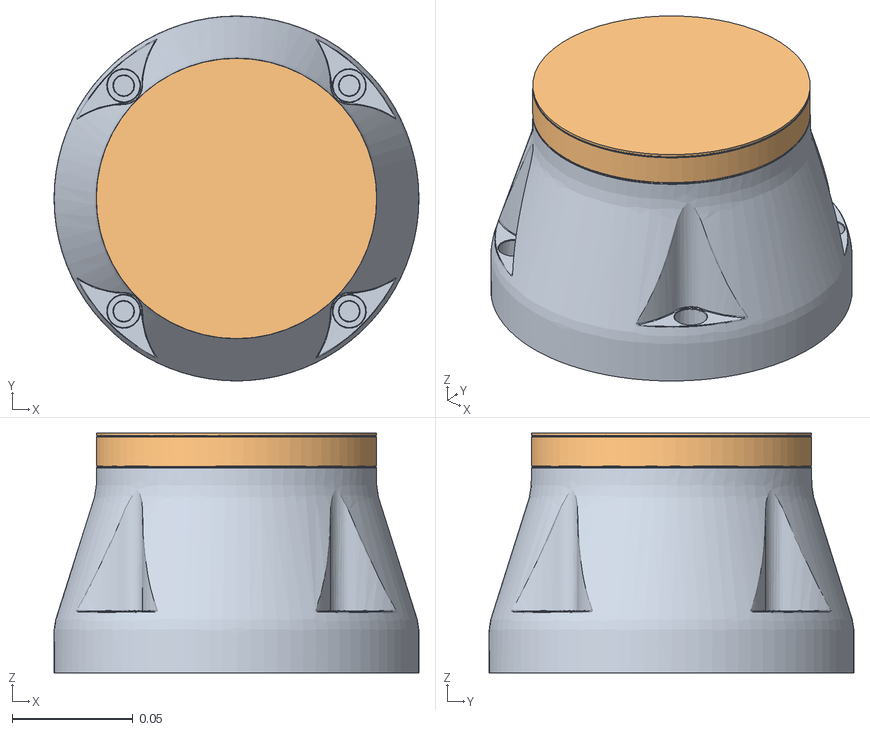
[picture p59: CAD file, 2026-09-24]
Teleop/assets/robots/arms/ur5e/meshes/visual/base.obj
0.151 x 0.151 x 0.0991
eSeries_UR5e_013
eSeries_UR5e_006
