zhzhen0626/FingerViP/Teleop/assets/robots/hands/allegro_hand/meshes/visual/link_12.0_right.obj

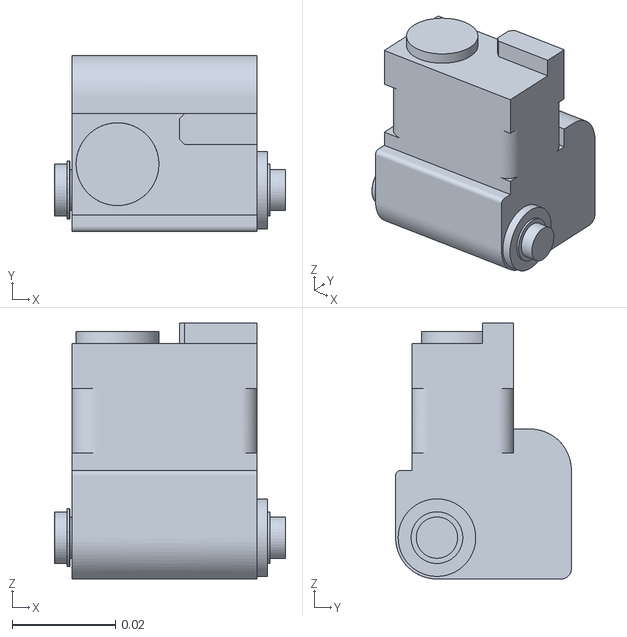
[picture p60: CAD file, 2026-09-24]
Teleop/assets/robots/hands/allegro_hand/meshes/visual/link_12.0_right.obj
0.0447 x 0.034 x 0.0495
