zhzhen0626/FingerViP/Teleop/assets/robots/hands/leap_hand/meshes/visual/palm_lower.obj

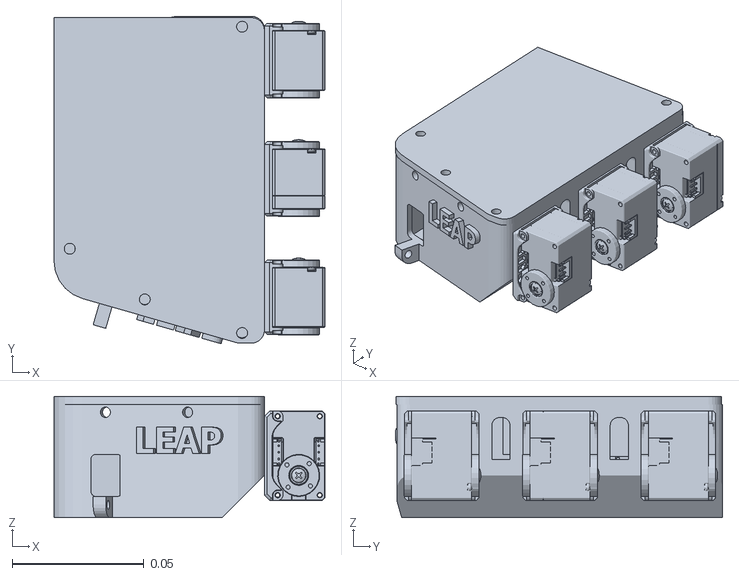
[picture p61: CAD file, 2026-09-24]
Teleop/assets/robots/hands/leap_hand/meshes/visual/palm_lower.obj
0.103 x 0.124 x 0.046
