zhzhen0626/FingerViP/Teleop/assets/robots/arms/ur10e/meshes/collision/upperarm.obj

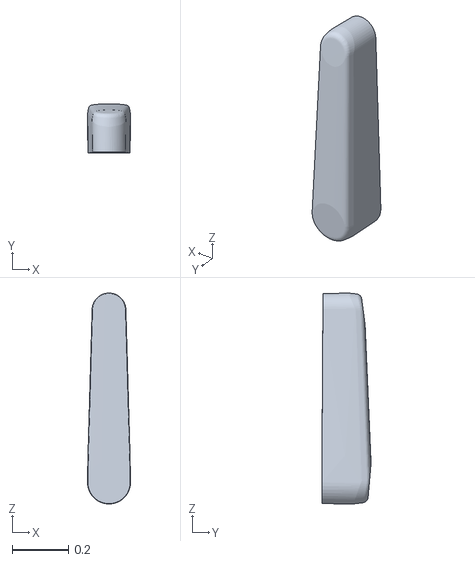
[picture p62: CAD file, 2026-09-24]
Teleop/assets/robots/arms/ur10e/meshes/collision/upperarm.obj
0.153 x 0.175 x 0.749
