zhzhen0626/FingerViP/Teleop/assets/robots/arms/ur10e/meshes/visual/wrist2.obj

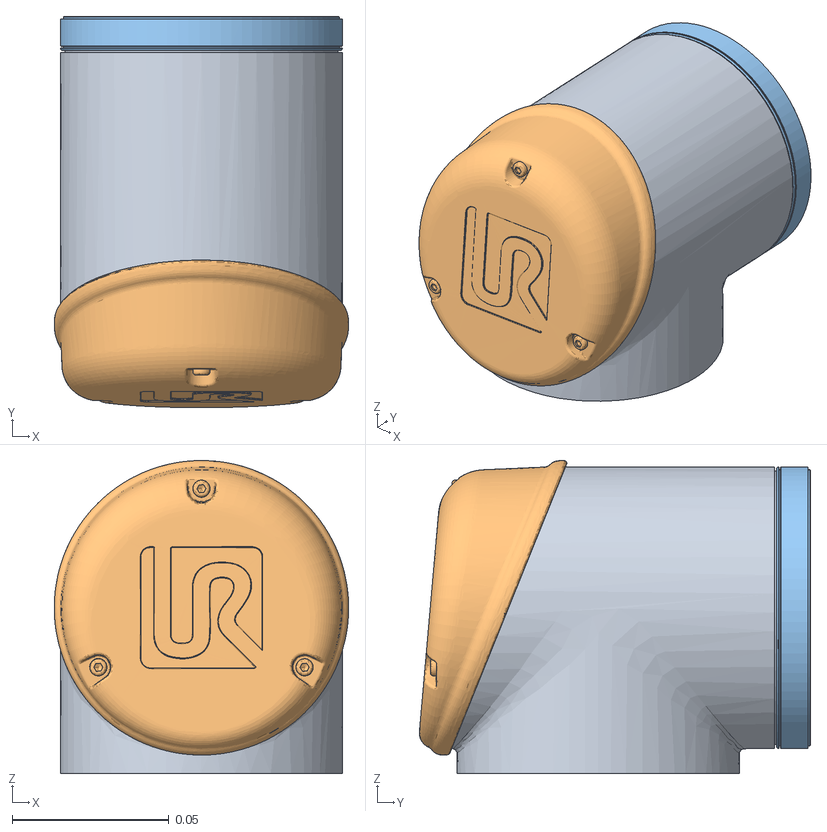
[picture p63: CAD file, 2026-09-24]
Teleop/assets/robots/arms/ur10e/meshes/visual/wrist2.obj
0.094 x 0.125 x 0.0999
eSeries_UR10e_040
eSeries_UR10e_030
eSeries_UR10e_035
