zhzhen0626/FingerViP/Teleop/assets/robots/hands/leap_hand/meshes/visual/mcp_joint.obj

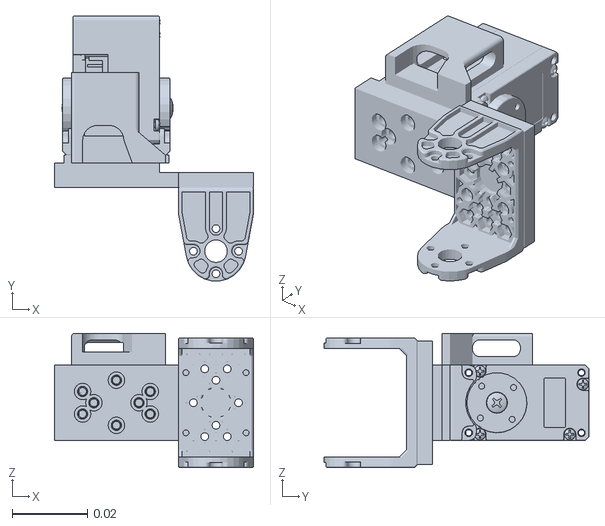
[picture p64: CAD file, 2026-09-24]
Teleop/assets/robots/hands/leap_hand/meshes/visual/mcp_joint.obj
0.053 x 0.0705 x 0.0358
