zhzhen0626/FingerViP/Teleop/assets/robots/hands/leap_hand/meshes/visual/thumb_fingertip.obj

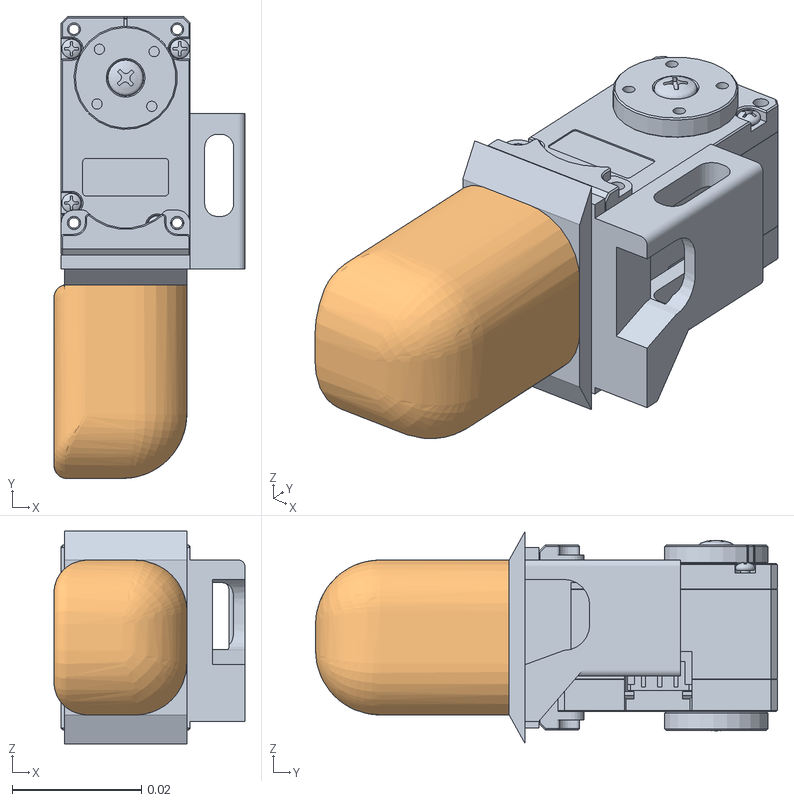
[picture p66: CAD file, 2026-09-24]
Teleop/assets/robots/hands/leap_hand/meshes/visual/thumb_fingertip.obj
0.0296 x 0.0716 x 0.033
thumb_fingertip
thumb_fingertip_W
