zhzhen0626/FingerViP/Teleop/assets/robots/hands/leap_hand/meshes/visual/thumb_dip.obj

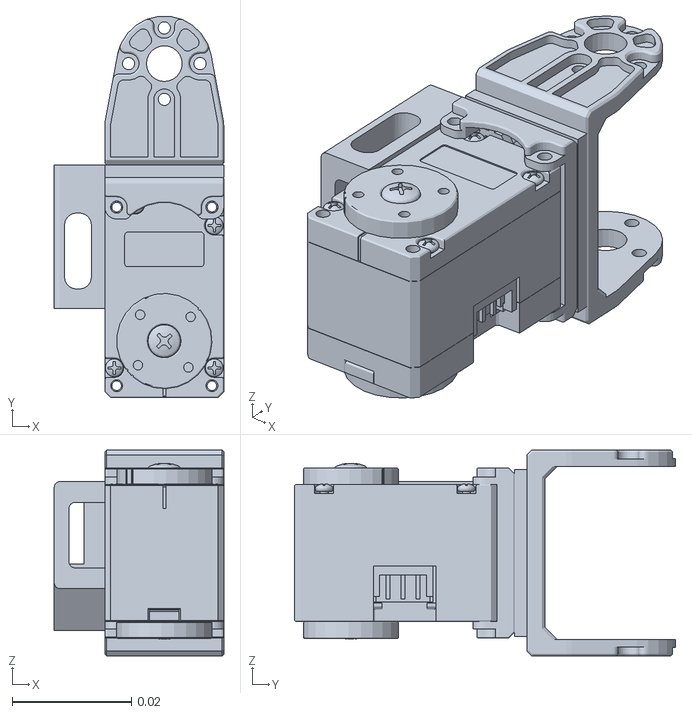
[picture p68: CAD file, 2026-09-24]
Teleop/assets/robots/hands/leap_hand/meshes/visual/thumb_dip.obj
0.0285 x 0.064 x 0.0346
