zhzhen0626/FingerViP/Teleop/assets/robots/hands/rapid_hand/meshes/TMCPS.STL

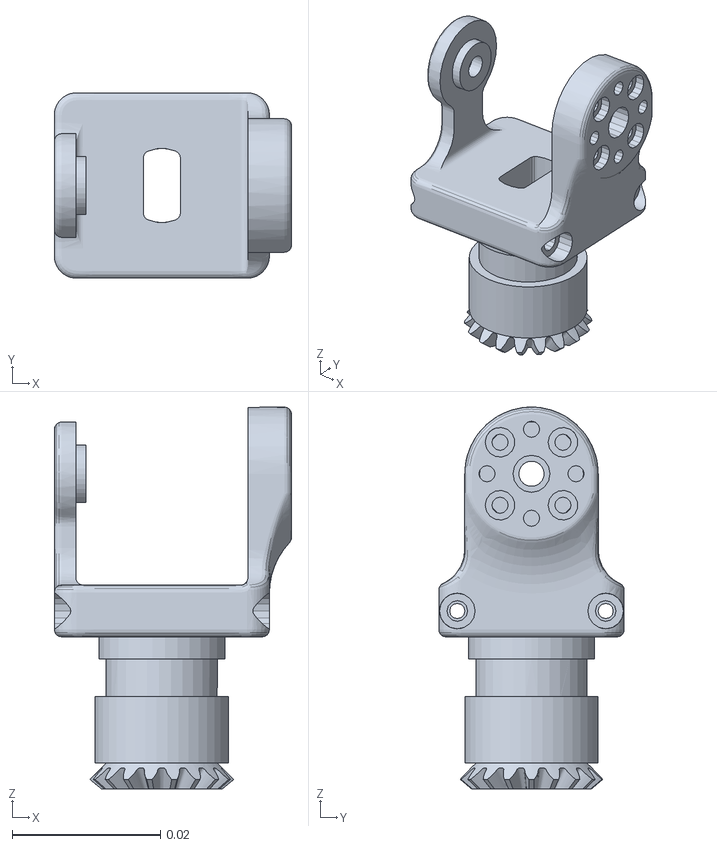
[picture p71: CAD file, 2026-09-24]
Teleop/assets/robots/hands/rapid_hand/meshes/TMCPS.STL
0.032 x 0.025 x 0.0515
