zhzhen0626/FingerViP/DiffusionPolicy/dexterous_hand/assets/hand/TDIP_CT.STL

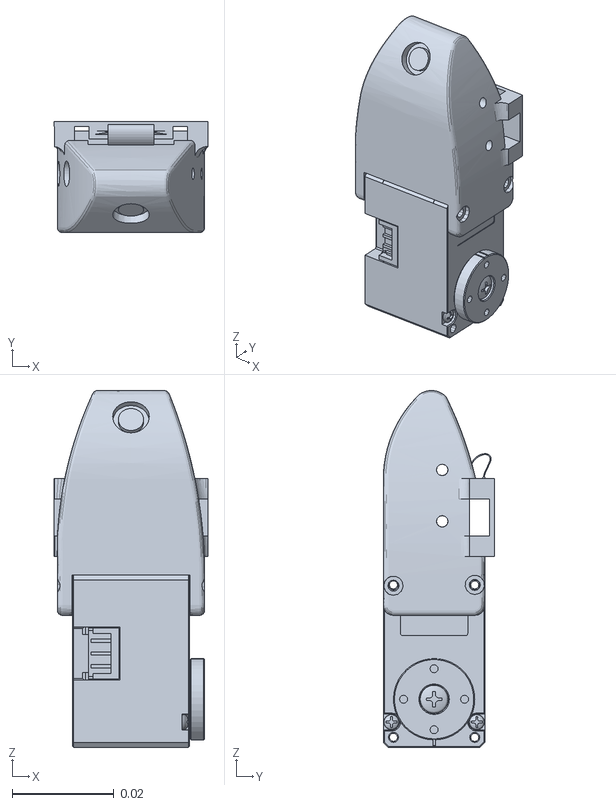
[picture p72: CAD file, 2026-09-24]
DiffusionPolicy/dexterous_hand/assets/hand/TDIP_CT.STL
0.0303 x 0.0219 x 0.0703
