zhzhen0626/FingerViP/(list of files, cad)

Other CAD files:
Teleop/assets/robots/hands/allegro_hand/meshes/visual/link_tip.obj
Teleop/assets/robots/hands/leap_hand/meshes/collision/white_tip.obj
DiffusionPolicy/dexterous_hand/assets/hand/TPIP.STL
Teleop/assets/robots/arms/ur10e/meshes/collision/base.obj
Teleop/assets/robots/hands/rapid_hand/meshes/LPIP.STL
DiffusionPolicy/dexterous_hand/assets/hand/LPIP.STL
Teleop/assets/robots/hands/rapid_hand/meshes/MMCPS.STL
DiffusionPolicy/dexterous_hand/assets/hand/RMCPF.STL
Teleop/assets/robots/hands/allegro_hand/meshes/visual/link_0.0.obj
Teleop/assets/robots/hands/leap_hand/meshes/visual/pip.obj
Teleop/assets/robots/hands/rapid_hand/meshes/MMCPF.STL
DiffusionPolicy/dexterous_hand/assets/hand/MPIP.STL
Teleop/assets/robots/hands/allegro_hand/meshes/visual/base_link_left.obj
Teleop/assets/robots/hands/rapid_hand/meshes/TPIP.STL
DiffusionPolicy/dexterous_hand/assets/hand/MMCPF.STL
Teleop/assets/robots/hands/rapid_hand/meshes/IMCPS.STL
Teleop/assets/robots/hands/rapid_hand/meshes/RMCPS.STL
Teleop/assets/robots/hands/allegro_hand/meshes/visual/link_13.0.obj
Teleop/assets/robots/hands/rapid_hand/meshes/IPIP.STL
Teleop/assets/robots/hands/rapid_hand/meshes/MPIP.STL
DiffusionPolicy/dexterous_hand/assets/hand/MMCPS.STL
Teleop/assets/robots/hands/rapid_hand/meshes/LDIP.STL
DiffusionPolicy/dexterous_hand/assets/hand/IPIP.STL
Teleop/assets/robots/hands/rapid_hand/meshes/RMCPF.STL
DiffusionPolicy/dexterous_hand/assets/hand/IMCPS.STL
Teleop/assets/robots/hands/rapid_hand/meshes/RDIP.STL
DiffusionPolicy/dexterous_hand/assets/hand/RMCPS.STL
Teleop/assets/robots/hands/rapid_hand/meshes/MDIP.STL
