zhzhen0626/FingerViP/DiffusionPolicy/diffusion_policy/config/task/panoptes.yaml

name: panoptes

camera_obs_latency: 0
robot_obs_latency: 0
dataset_frequeny: 30
obs_down_sample_steps: 1 # 3, 1

low_dim_obs_horizon: 2
img_obs_horizon: 2
action_horizon: 16
ignore_proprioception: False

shape_meta: &shape_meta
  # acceptable types: rgb, low_dim
  obs:
    camera0_rgb:
      shape: [3, 224, 224]
      horizon: ${task.img_obs_horizon} # int
      latency_steps: 0 # float
      down_sample_steps: ${task.obs_down_sample_steps} # int
      type: rgb
      ignore_by_policy: False
    camera1_rgb:
      shape: [3, 224, 224]
      horizon: ${task.img_obs_horizon} # int
      latency_steps: 0 # float
      down_sample_steps: ${task.obs_down_sample_steps} # int
      type: rgb
      ignore_by_policy: False
    camera2_rgb:
      shape: [3, 224, 224]
      horizon: ${task.img_obs_horizon} # int
      latency_steps: 0 # float
      down_sample_steps: ${task.obs_down_sample_steps} # int
      type: rgb
      ignore_by_policy: False
    camera3_rgb:
      shape: [3, 224, 224]
      horizon: ${task.img_obs_horizon} # int
      latency_steps: 0 # float
      down_sample_steps: ${task.obs_down_sample_steps} # int
      type: rgb
      ignore_by_policy: False
    camera4_rgb:
      shape: [3, 224, 224]
      horizon: ${task.img_obs_horizon} # int
      latency_steps: 0 # float
      down_sample_steps: ${task.obs_down_sample_steps} # int
      type: rgb
      ignore_by_policy: False
    camera5_rgb:
      shape: [3, 224, 224]
      horizon: ${task.img_obs_horizon} # int
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
      type: low_dim
      ignore_by_policy: ${task.ignore_proprioception}
    camera_ori:
      shape: [21, 6]
      horizon: ${task.low_dim_obs_horizon} # int
      latency_steps: 0 # float
      down_sample_steps: ${task.obs_down_sample_steps} # float
      type: low_dim
      ignore_by_policy: ${task.ignore_proprioception}
  action: 
    shape: [9]
    horizon: ${task.action_horizon}
    latency_steps: 0 # float
    down_sample_steps: ${task.obs_down_sample_steps} # int

task_name: &task_name snake
dataset_path: dataset.zarr.zip

env_runner:
  _target_: diffusion_policy.env_runner.real_pusht_image_runner.RealPushTImageRunner

dataset:
  _target_: diffusion_policy.dataset.snake_blockpush_dataset.SnakeBlockPushDataset
  shape_meta: *shape_meta
  dataset_path: ${task.dataset_path}
  cache_dir: null
  action_padding: False
  temporally_independent_normalization: False
  repeat_frame_prob: 0.0
  max_duration: null
  seed: 42
  val_ratio: 0.05
  random_erase: False
  random_erase_prob: 0.5
  random_dropout: True
  random_dropout_prob: 0.05
