zhzhen0626/FingerViP/DiffusionPolicy/diffusion_policy/config/train_fingervip_workspace.yaml

defaults:
  - _self_
  - task: fingervip

name: train_diffusion_transformer_timm
_target_: diffusion_policy.workspace.train_diffusion_transformer_timm_workspace.TrainDiffusionTransformerTimmWorkspace

task_name: ${task.name}
shape_meta: ${task.shape_meta}
exp_name: "default"

n_action_steps: 8
n_emb: 768

policy:
  _target_: diffusion_policy.policy.diffusion_transformer_timm_policy.DiffusionTransformerTimmPolicy

  shape_meta: ${shape_meta}
  
  noise_scheduler:
    _target_: diffusers.DDIMScheduler
    num_train_timesteps: 50
    beta_start: 0.0001
    beta_end: 0.02
    # beta_schedule is important
    # this is the best we found
    beta_schedule: squaredcos_cap_v2
    clip_sample: True
    set_alpha_to_one: True
    steps_offset: 0
    prediction_type: epsilon # or sample

  obs_encoder:
    _target_: diffusion_policy.model.vision.transformer_obs_encoder.TransformerObsEncoder
    shape_meta: ${shape_meta}
    global_pool: ''
    n_emb: ${n_emb}
    add_camera_poses: True
    add_joint_current: True

    model_name: 'vit_base_patch16_clip_224.openai'
    # model_name: 'vit_base_patch14_dinov2.lvd142m'
    pretrained: True
    frozen: True

    # 'cls' or 'avg' or 'max' or 'soft_attention' or 'spatial_embedding' or 'transformer' or 'attention_pool_2d'
    feature_aggregation: 'cls'

    # it only works for resnet. 32 (7x7) or 16 (14x14)
    downsample_ratio: 32

    transforms:
      - _target_: torchvision.transforms.ColorJitter
        brightness: 0.3
        contrast: 0.4
        saturation: 0.5
        hue: 0.08
      - _target_: torchvision.transforms.RandomApply
        p: 0.02
        transforms:
          - _target_: torchvision.transforms.GaussianBlur
            kernel_size: 3
            sigma: [0.1, 0.3]
      
    use_group_norm: True
    share_rgb_model: True
    imagenet_norm: True
    concat_camera_poses: True
    concat_joint_current: True

  num_inference_steps: 16
  input_pertub: 0.1 # reference: https://github.com/forever208/DDPM-IP
  n_layer: 7
  n_head: 8
  n_emb: ${n_emb}
  p_drop_attn: 0.1
  

ema:
  _target_: diffusion_policy.model.diffusion.ema_model.EMAModel
  update_after_step: 0
  inv_gamma: 1.0
  power: 0.75
  min_value: 0.0
  max_value: 0.9999

dataloader:
  batch_size: 64
  num_workers: 8
  shuffle: True
  pin_memory: True
  persistent_workers: True

val_dataloader:
  batch_size: 32
  num_workers: 8
  shuffle: False
  pin_memory: True
  persistent_workers: True

optimizer:
  lr: 3.0e-4
  weight_decay: 1.0e-6
  obs_encoder_lr: 3.0e-5
  obs_encoder_weight_decay: 1.0e-6
  betas: [0.95, 0.999]
  
training:
  device: "cuda:0"
  seed: 42
  debug: False
  resume: False
  # optimization
  lr_scheduler: cosine
  lr_warmup_steps: 2000
  num_epochs: 100
  gradient_accumulate_every: 1
  # EMA destroys performance when used with BatchNorm
  # replace BatchNorm with GroupNorm.
  use_ema: True
  freeze_encoder: False
  # training loop control
  # in epochs
  rollout_every: 10
  checkpoint_every: 10
  val_every: 1
  sample_every: 5
  # steps per epoch
  max_train_steps: null
  max_val_steps: null
  # misc
  tqdm_interval_sec: 1.0

logging:
  project: dexterous_hand
  resume: False
  mode: online
  name: ${now:%Y.%m.%d-%H.%M.%S}_${name}_${task_name}
  tags: ["${name}", "${task_name}", "${exp_name}"]
  id: null
  group: null

checkpoint:
  topk:
    monitor_key: train_loss
    mode: min
    k: 20
    format_str: 'epoch={epoch:04d}-train_loss={train_loss:.3f}.ckpt'
  save_last_ckpt: True
  save_last_snapshot: False

output_dir: outputs/${now:%Y.%m.%d}/${now:%H.%M.%S}_${name}_${task_name}

multi_run:
  run_dir: outputs/${now:%Y.%m.%d}/${now:%H.%M.%S}_${name}_${task_name}
  wandb_name_base: ${now:%Y.%m.%d-%H.%M.%S}_${name}_${task_name}

hydra:
  job:
    override_dirname: ${name}
  run:
    dir: outputs/${now:%Y.%m.%d}/${now:%H.%M.%S}_${name}_${task_name}
  sweep:
    dir: outputs/${now:%Y.%m.%d}/${now:%H.%M.%S}_${name}_${task_name}
    subdir: ${hydra.job.num}
