zhzhen0626/FingerViP/Teleop/args/robot_args/arm_args/ur5e_rapid.yaml

robot_cfg:
  dt: 0.05
  urdf_path: arms/ur5e/ur5e.urdf

  kinematics:
    ik_damping: 1e-5
    eps: 1e-3
    ee_link: ee_link

init_qpos:
  shoulder_pan_joint :     -0.2230
  shoulder_lift_joint :    -1.2892
  elbow_joint :    2.7728
  wrist_1_joint :  -2.2508
  wrist_2_joint :  1.3989
  wrist_3_joint :  0.1320

rotation_matrix: [[1,0,0],[0,1,0],[0,0,1]]
transform_matrix: [[1,0,0],[0,1,0],[0,0,1]]

ur5e_command_order:
  [
    "shoulder_pan_joint",
    "shoulder_lift_joint",
    "elbow_joint",
    "wrist_1_joint",
    "wrist_2_joint",
    "wrist_3_joint",
  ]
